dpflores/BLDC_Motor_Controller_SEM_2022/README.md

# BLDC_Motor_Controller_SEM_2022

Desarrollo del controlador de motor brushless DC utilizado por KON Team para la competencia Shell Eco-Marathon Brasil 2022. Este código se ha implementado en un microcontrolador STM32F103C8T6. 

Revisar la carpeta `documentation` para ver el desarrollo de hardware.

Saludos de parte del equipo de electrónica de KON Team.
