dpflores/BLDC_Motor_Controller_SEM_2022/documentation/1 cover.pdf

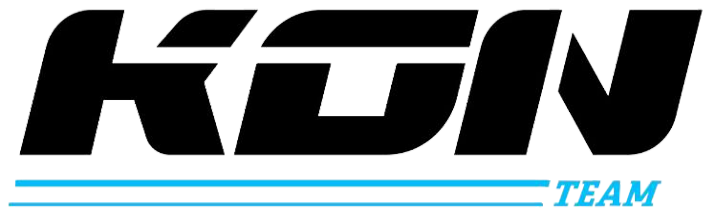
[picture p1: figure]

Motor Controller
Documentation

2021/2022

Team ID: PE0002001

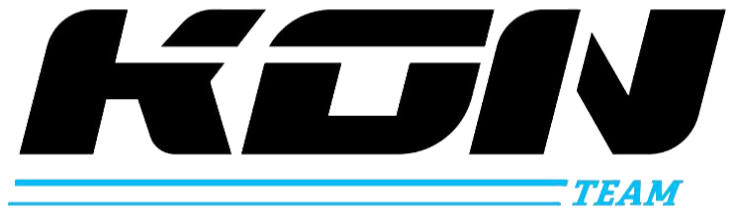
[picture p2: figure]

2
