dpflores/BLDC_Motor_Controller_SEM_2022/documentation/8 CAD model.pdf

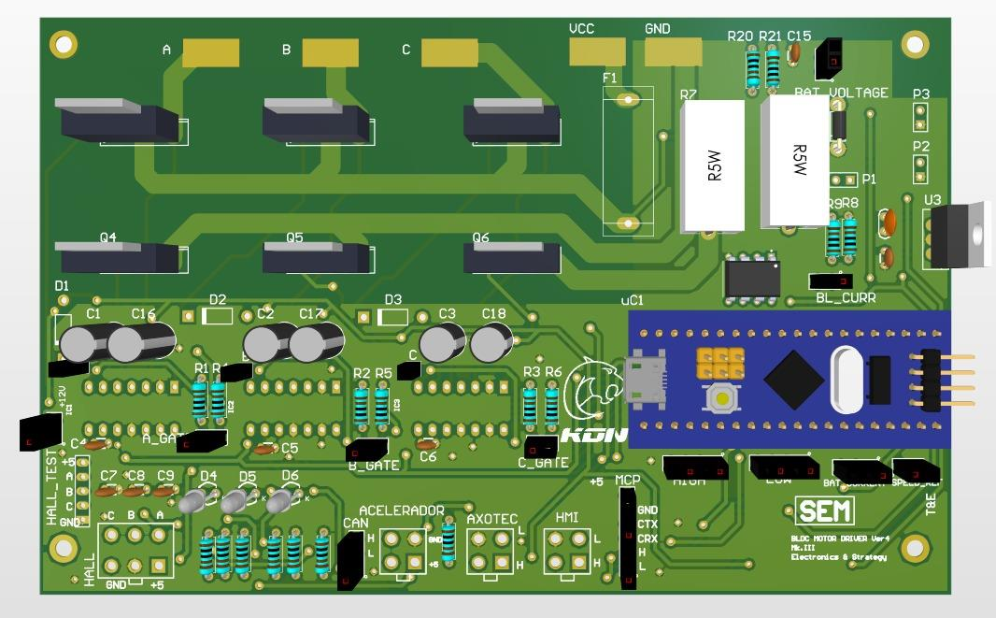
[picture p3: page 1]
