dpflores/BLDC_Motor_Controller_SEM_2022/documentation/4 PCBKon_Schematic.pdf

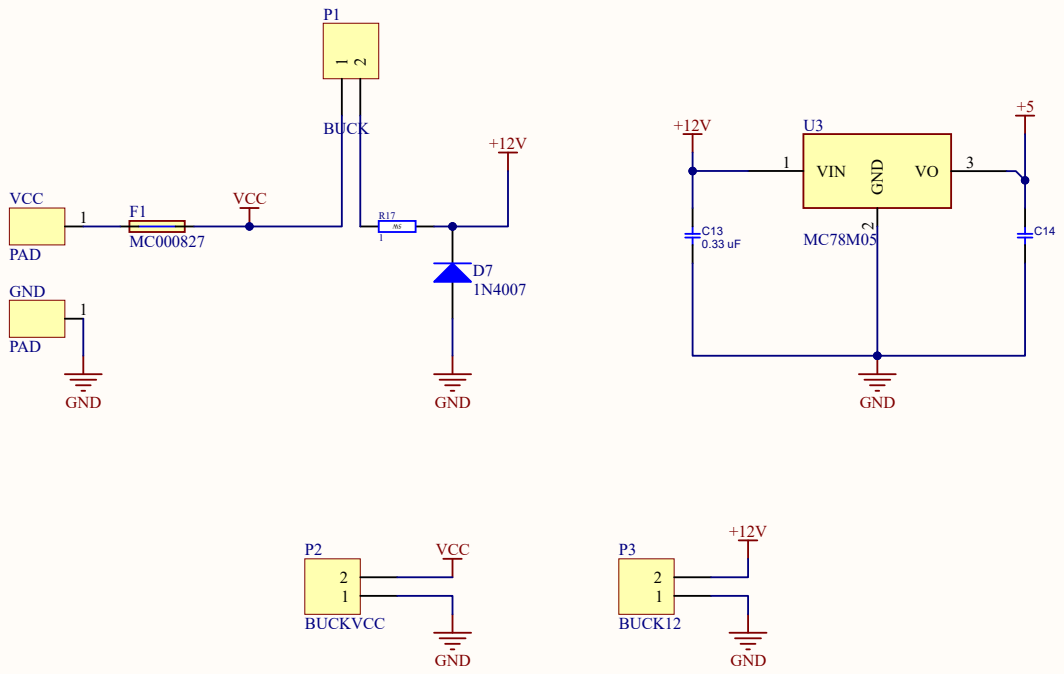
[picture p4: page 1]

Size A4 | Number | Revision

Date: 8/19/2022 | Sheet of
File: C:\Users\..\Buck.SchDoc | Drawn By:

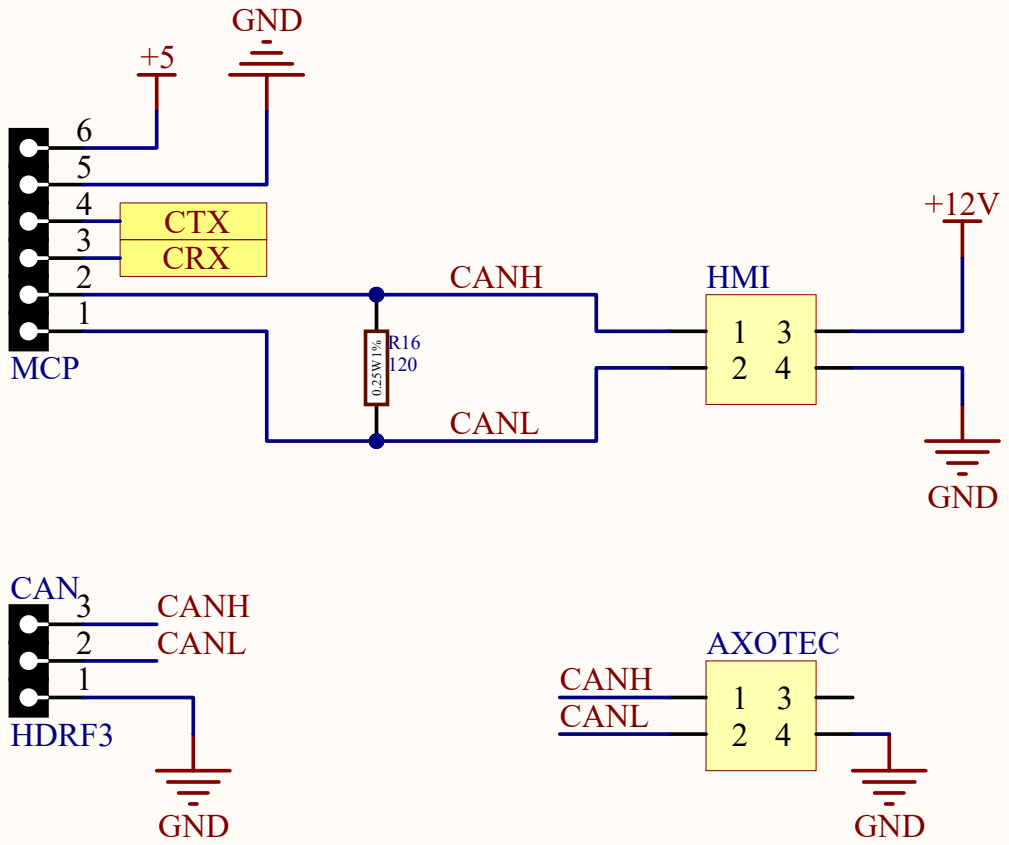
[picture p5: page 2]
Title; Size; Number; Revision; File:; C:\Users\..\CANBUS.SchDoc; Drawn By:; MCP; CTX CRX; GND; CANH; HMI; CANL; AXOTEC; 3 CAN; HDRF3; CANH CANL

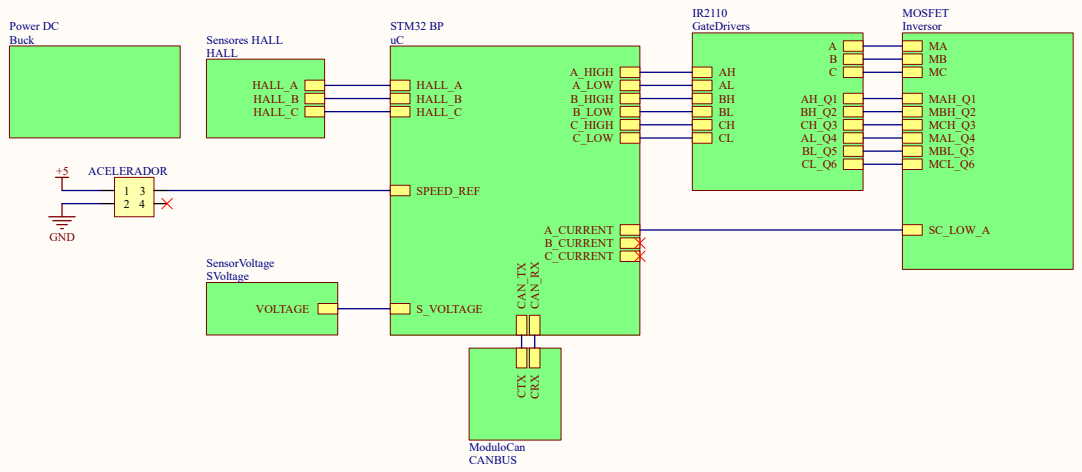
[picture p6: page 3]
Title; Size; Number; Revision; File:; C:\Users\..\Driverv4_1.SchDoc; Drawn By:; A_HIGH; HALL_A; CAN_TX; C_HIGH; B_HIGH; CAN_RX; HALL_B; C_LOW; A_LOW; SPEED_REF; HALL_C; B_LOW; A_CURRENT B_CURRENT C_CURRENT; S_VOLTAGE; STM32 BP; IR2110 GateDrivers; MAL_Q4; MAH_Q1; MCL_Q6; MBH_Q2 MCH_Q3; MBL_Q5; SC_LOW_A; MOSFET Inversor; CTX; CRX; ModuloCan CANBUS; HALL_A HALL_B HALL_C; Sensores HALL HALL; Power DC Buck; ACELERADOR; GND; VOLTAGE; SensorVoltage SVoltage

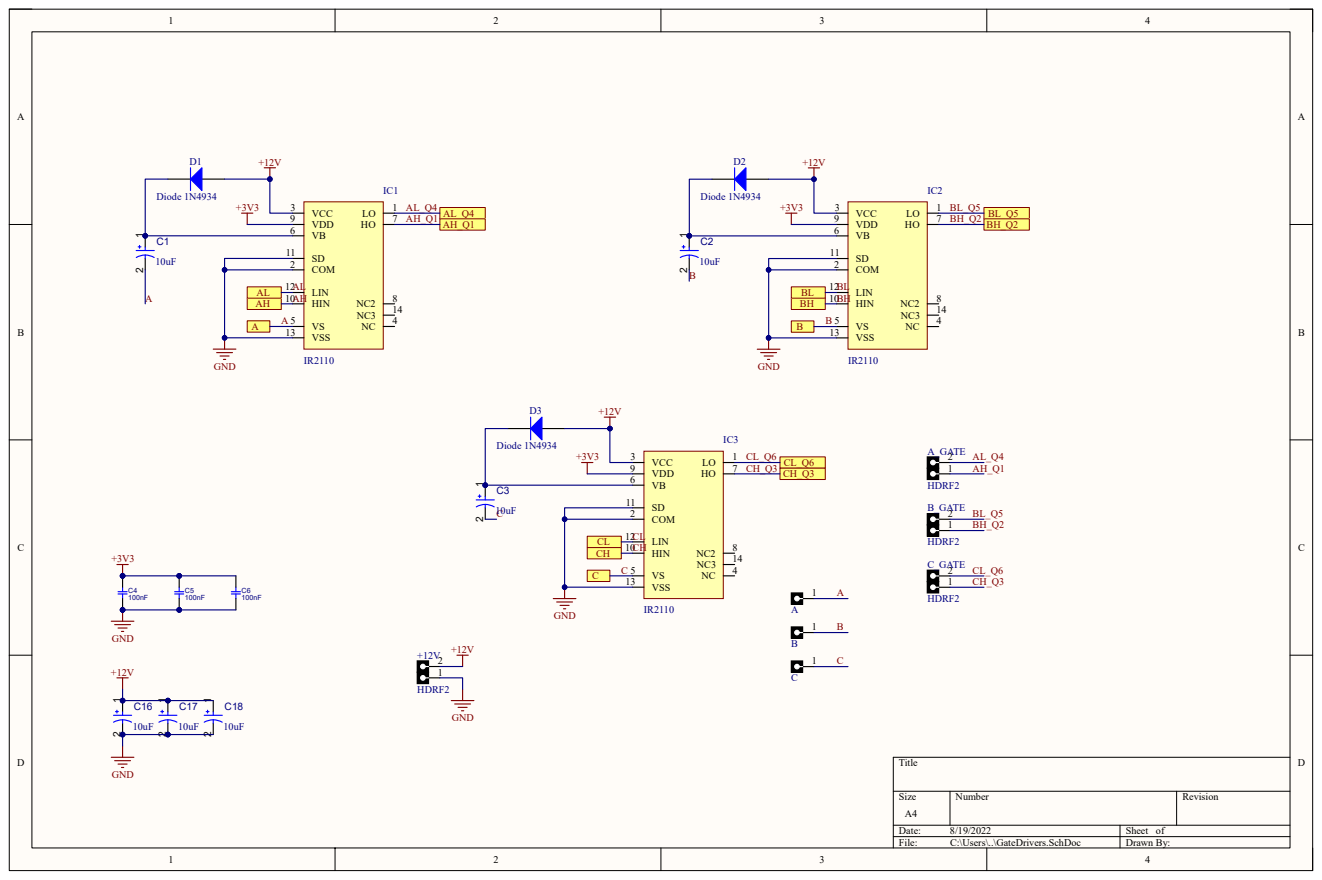
[picture p7: page 4]

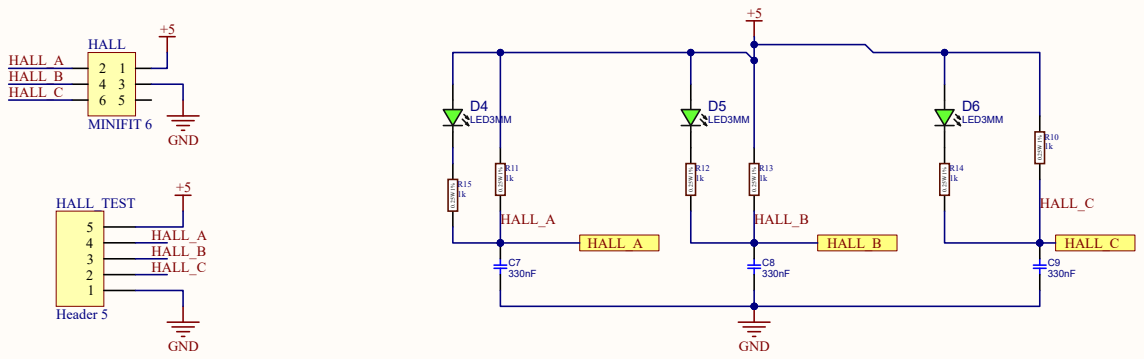
[picture p8: page 5]
Title; Size; Number; Revision; File:; C:\Users\..\HALL.SchDoc; Drawn By:; GND; HALL_A; HALL_B; HALL_C; HALL; MINIFIT 6; HALL_TEST; Header 5; HALL_A HALL_B HALL_C; LED3MM

# Ciruito Inversor de Potencia

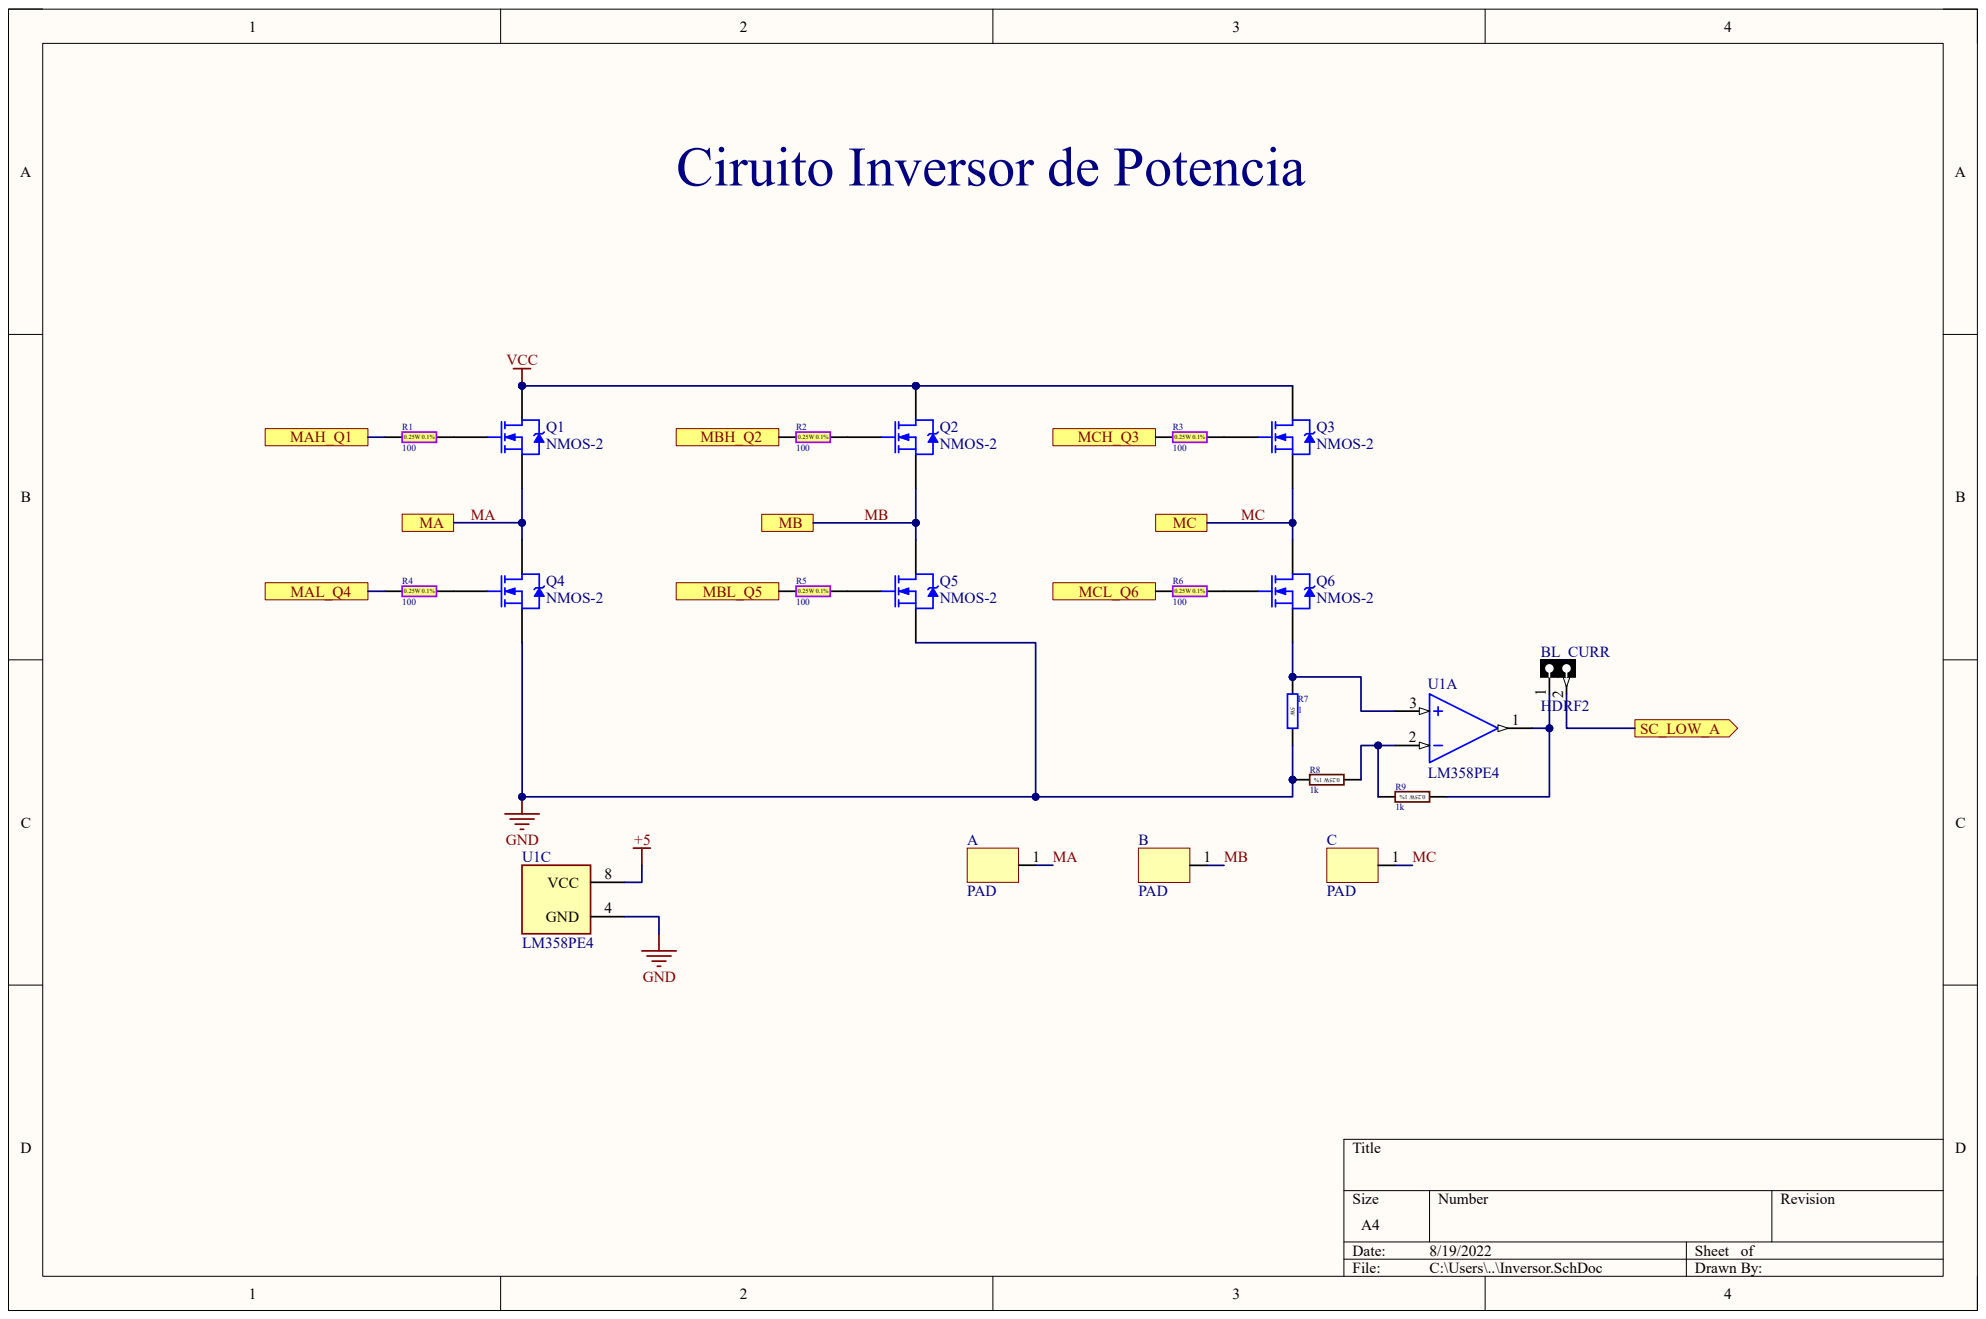
[picture p9: page 6]

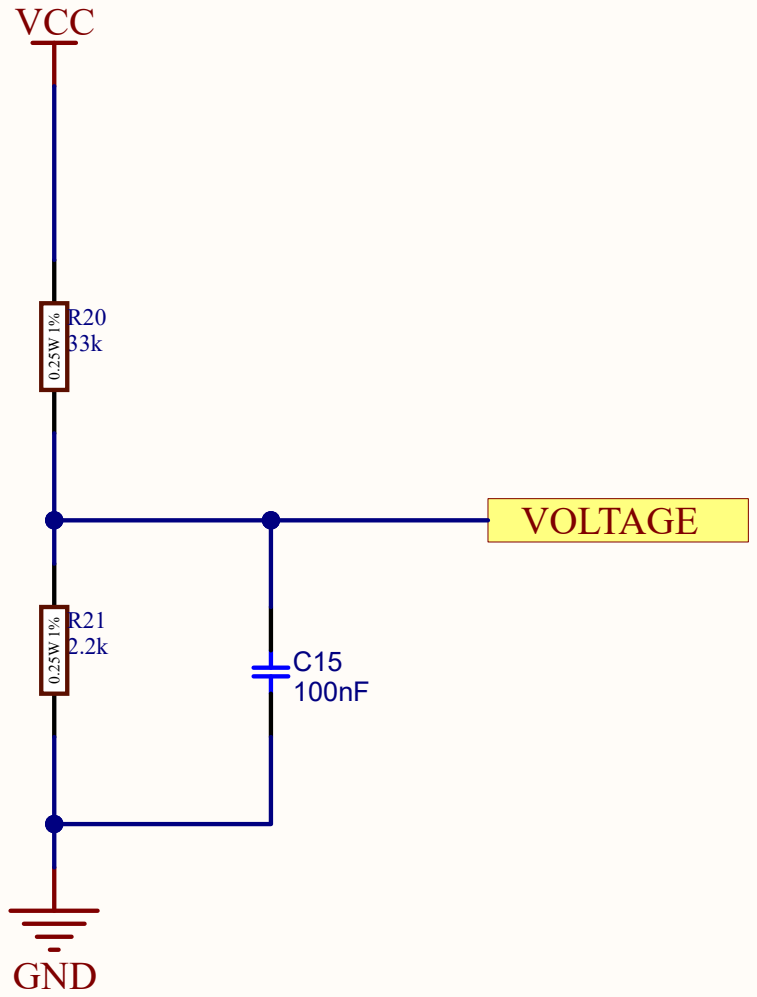
[picture p10: page 7]
Title; Size; Number; Revision; File:; C:\Users\..\SVoltage.SchDoc; Drawn By:; GND; VCC; VOLTAGE

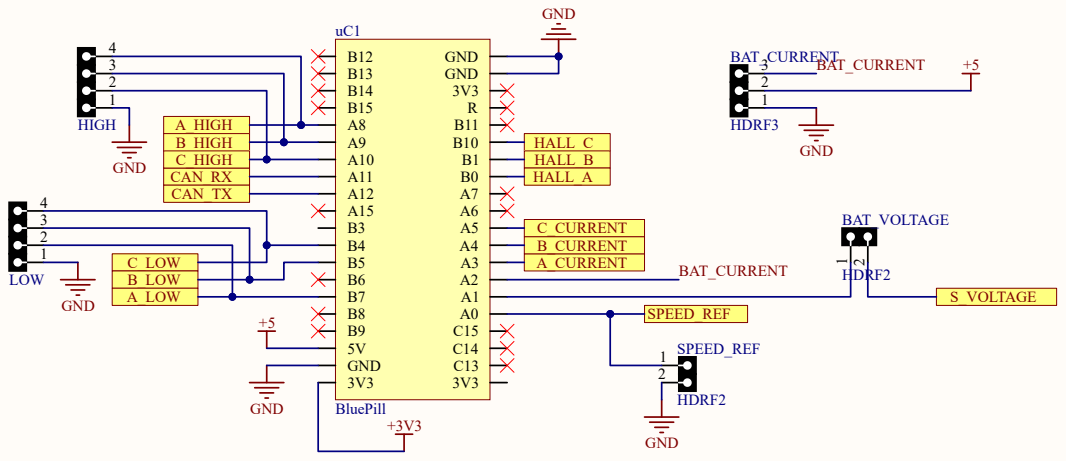
[picture p11: page 8]
Title; Size; Number; Revision; File:; C:\Users\..\uC.SchDoc; Drawn By:; GND; B13 B14 B15 A8 A9 A10 A11 A12 A15 B3 B4 B5 B6 B7 B8 B9 5V GND 3V3; BluePill; CAN_RX CAN_TX; A_HIGH B_HIGH C_HIGH; HALL_C HALL_B HALL_A; C_LOW B_LOW A_LOW; SPEED_REF; A_CURRENT; B_CURRENT; C_CURRENT; S_VOLTAGE; HIGH; LOW; BAT_VOLTAGE; HDRF2; BAT_CURRENT; 3 BAT_CURRENT; HDRF3
