dpflores/BLDC_Motor_Controller_SEM_2022/documentation/15 Energy Supply.pdf

## Energy Supply Block Diagram - KON Team Mk III

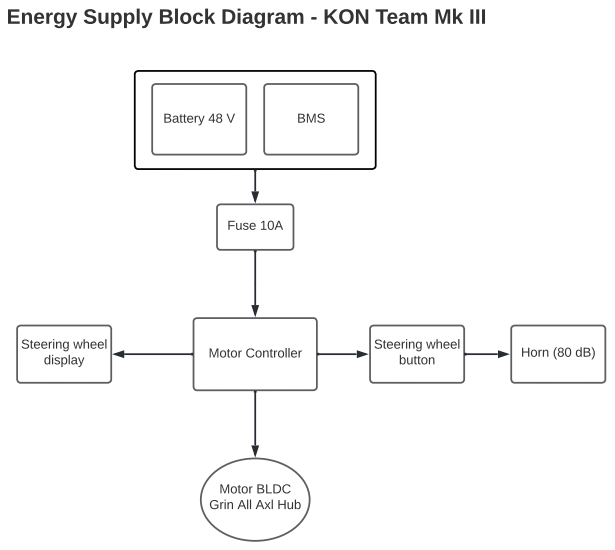
[picture p12: page 1]
Battery 48 V; BMS; Fuse 10A; Motor Controller; Steering wheel button

Horn (80 dB) Steering wheel
display

Motor BLDC
Grin All Axl Hub
