dpflores/BLDC_Motor_Controller_SEM_2022/documentation/16 Propulsion System.pdf

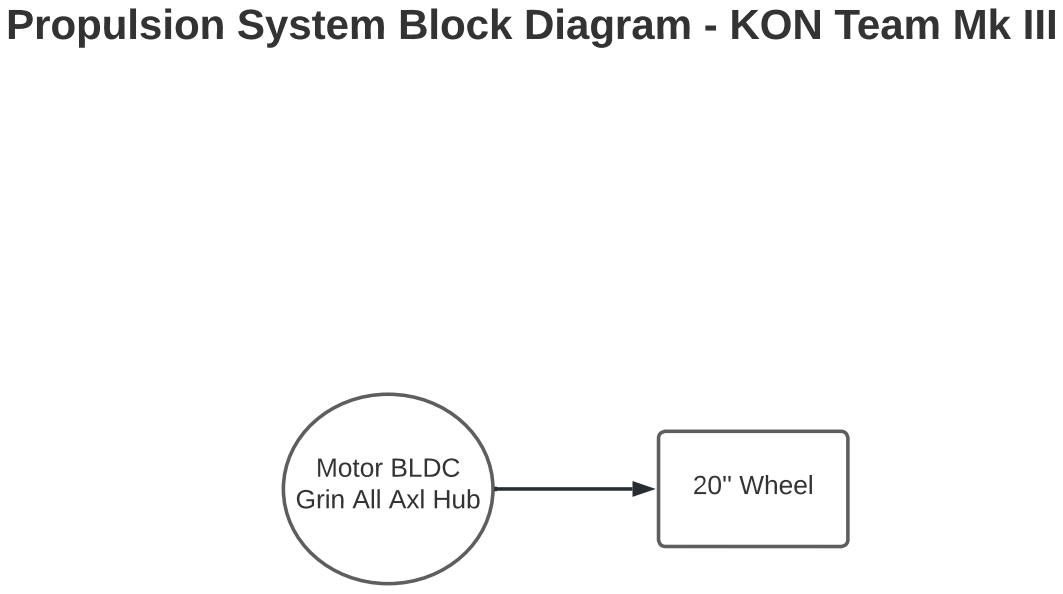
[picture p13: page 1]
20'' Wheel

Propulsion System Block Diagram - KON Team Mk III

Motor BLDC
Grin All Axl Hub
