dpflores/BLDC_Motor_Controller_SEM_2022/documentation/2 Block diagram.pdf

# Electronic Speed Controller (Hardware)

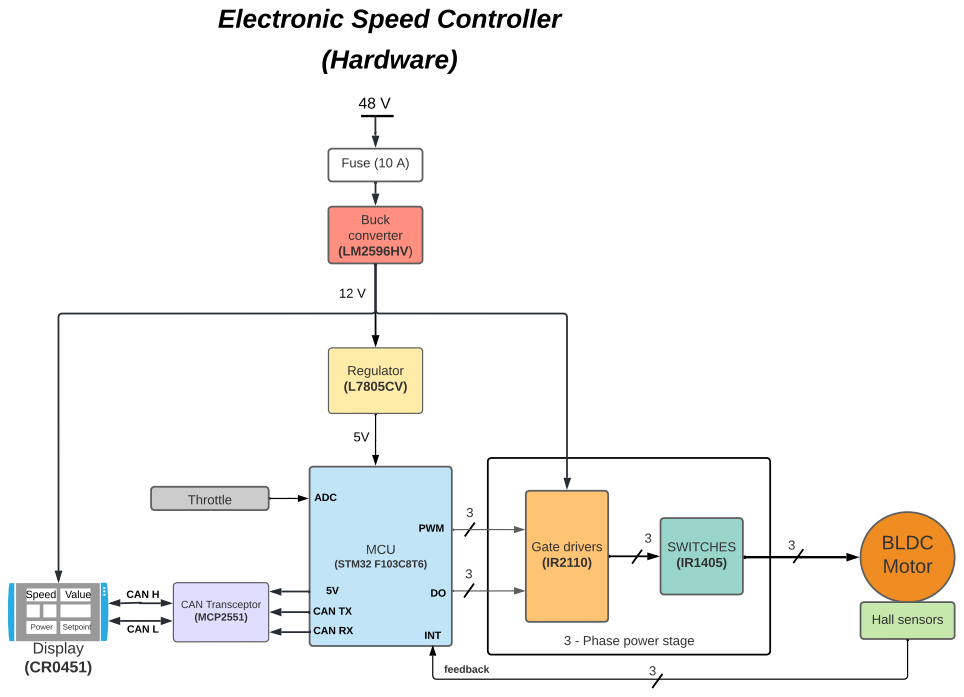
[picture p14: page 1]
Buck converter (LM2596HV); MCU (STM32 F103C8T6); BLDC Motor; Hall sensors; Gate drivers (IR2110); SWITCHES (IR1405); feedback; Throttle; Regulator (L7805CV); ADC; CAN TX; PWM; INT; Fuse (10 A); CAN RX; CAN Transceptor (MCP2551); CAN L; CAN H; Display (CR0451); Speed Value; Power Setpoint

3 - Phase power stage
