dpflores/BLDC_Motor_Controller_SEM_2022/documentation/3 Flowcharts.pdf

### MAIN PROGRAM

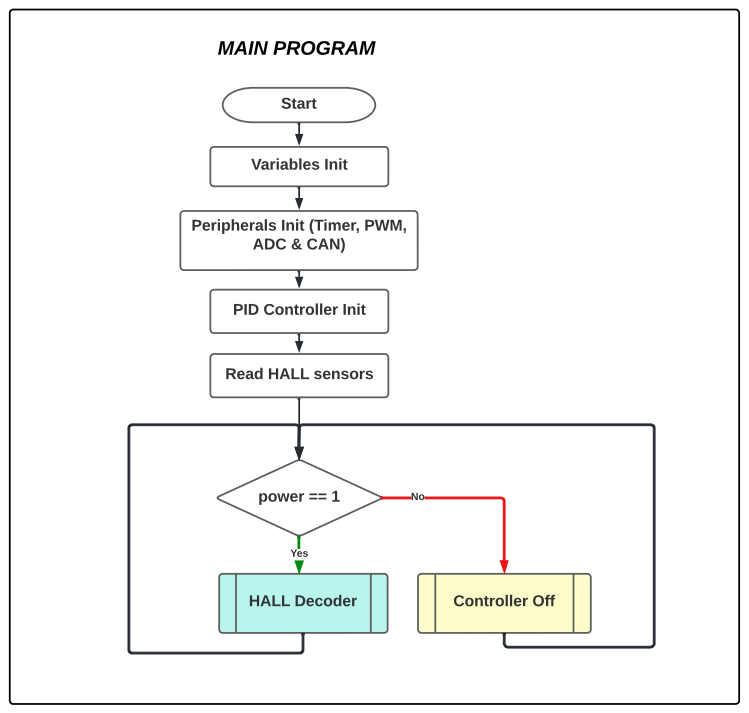
[picture p15: page 1]
Start; Variables Init; power == 1; HALL Decoder; Yes; Controller Off; ADC & CAN)

Peripherals Init (Timer, PWM,

PID Controller Init

Read HALL sensors

### HALL Decoder Subroutine

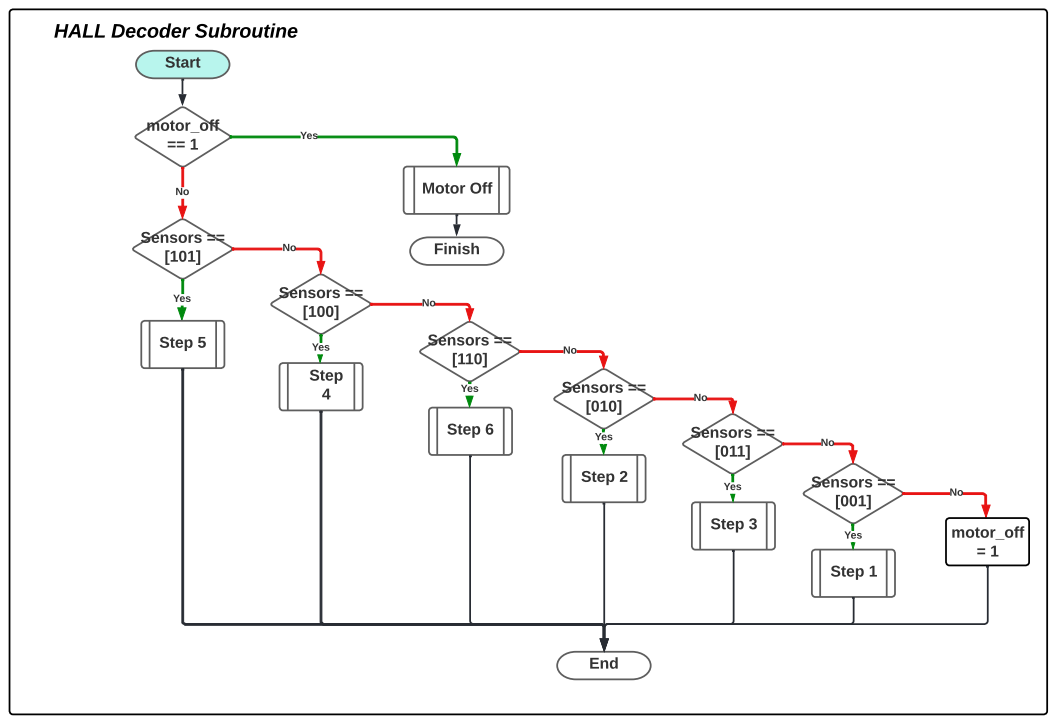
[picture p16: page 2]
Sensors == [101]; Yes; Step 5; Sensors == [100]; Step 4; Sensors ==; Step 6; Sensors == [010]; Step 2; Sensors == [011]; Step 3; Sensors == [001]; Step 1; Start; End; motor_off == 1; Motor Off; Finish; motor_off = 1

### Interrupt routines

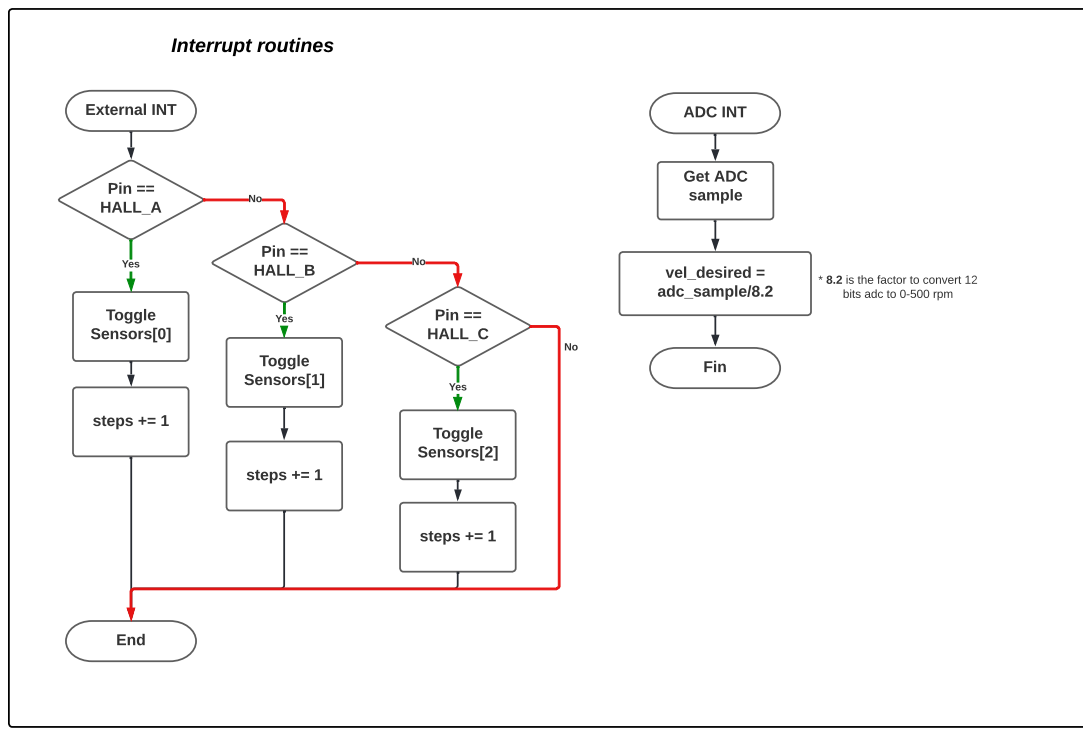
[picture p17: page 3]
External INT; Pin == HALL_A; Toggle Sensors[0]; Yes; steps += 1; End; Pin == HALL_B; Toggle Sensors[1]; Pin == HALL_C; Toggle Sensors[2]; ADC INT; Get ADC sample; vel_desired = adc_sample/8.2; Fin

* 8.2 is the factor to convert 12
bits adc to 0-500 rpm

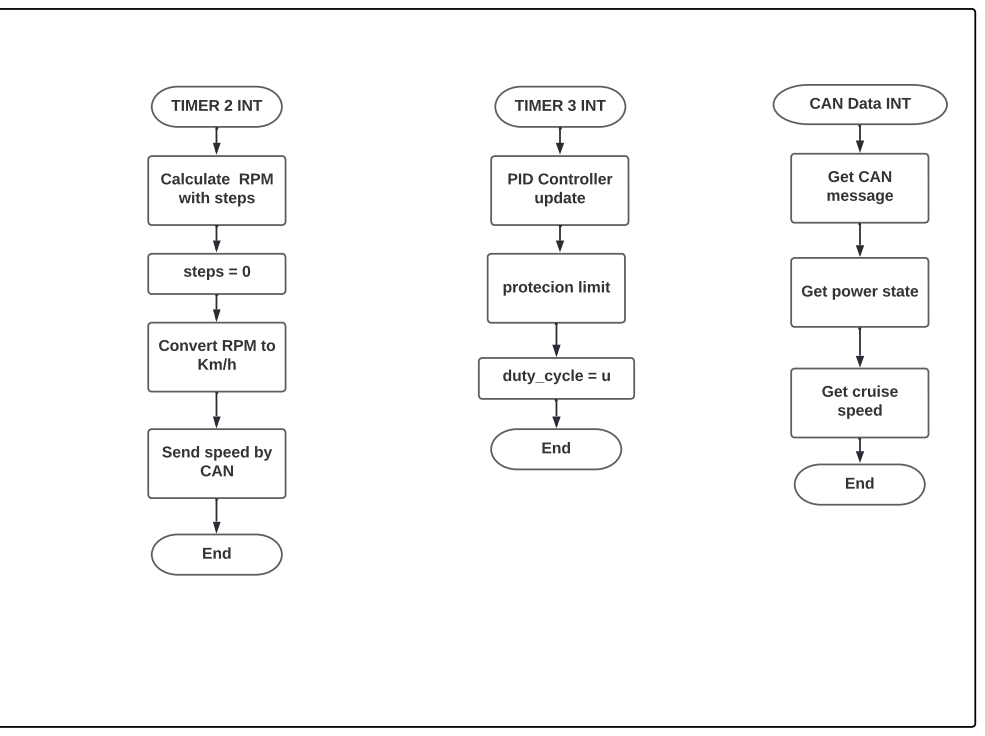
[picture p18: page 4]
TIMER 2 INT; Calculate RPM with steps; steps = 0; End; TIMER 3 INT; PID Controller update; protecion limit; duty_cycle = u; Get CAN message; Get cruise speed

CAN Data INT

Get power state

Convert RPM to

Send speed by
CAN
