dpflores/BLDC_Motor_Controller_SEM_2022/documentation/Final document.pdf

# Motor Controller Documentation

2021/2022

# Team ID: PE0002001

48 V

# Electronic Speed Controller

Buck converter (LM2596HV); MCU (STM32 F103C8T6); BLDC Motor; Hall sensors; Gate drivers (IR2110); SWITCHES (IR1405); feedback; Throttle; Regulator (L7805CV); (Hardware); ADC; CAN TX; PWM; INT; Fuse (10 A); CAN RX; CAN Transceptor (MCP2551); CAN L; CAN H; Display (CR0451); Speed Value; Power Setpoint

3 - Phase power stage

# Start

# Variables Init

power == 1; HALL Decoder; Yes; Controller Off; ADC & CAN); MAIN PROGRAM

Peripherals Init (Timer, PWM,

PID Controller Init

Read HALL sensors

# Start

# motor_off

Sensors == [101]; Yes; Step 5; Sensors == [100]; Step 4; Sensors ==; Step 6; Sensors == [010]; Step 2; Sensors == [011]; Step 3; Sensors == [001]; Step 1; End; Motor Off; Finish; motor_off = 1

HALL Decoder Subroutine

# External INT

# Interrupt routines

Pin == HALL_A; Toggle Sensors[0]; Yes; steps += 1; End; Pin == HALL_B; Toggle Sensors[1]; Pin == HALL_C; Toggle Sensors[2]; ADC INT; Get ADC sample; vel_desired = adc_sample/8.2; Fin

* 8.2 is the factor to convert 12
bits adc to 0-500 rpm

# TIMER 2 INT

# TIMER 3 INT

Calculate RPM with steps; steps = 0; End; PID Controller update; protecion limit; duty_cycle = u; Get CAN message; Get cruise speed

CAN Data INT

Get power state

Convert RPM to

Send speed by
CAN


Size A4 | Number | Revision

Date: 8/19/2022 | Sheet of
File: C:\Users\..\Buck.SchDoc | Drawn By:

Title; MCP; CTX CRX; GND; CANH; HMI; CANL; AXOTEC; 3 CAN; HDRF3; CANH CANL

Size A4 | Number | Revision

Date: 8/19/2022 | Sheet of
File: C:\Users\..\CANBUS.SchDoc | Drawn By:

Title; A_HIGH; HALL_A; CAN_TX; C_HIGH; B_HIGH; CAN_RX; HALL_B; C_LOW; A_LOW; SPEED_REF; HALL_C; B_LOW; A_CURRENT B_CURRENT C_CURRENT; S_VOLTAGE; STM32 BP; IR2110 GateDrivers; MAL_Q4; MAH_Q1; MCL_Q6; MBH_Q2 MCH_Q3; MBL_Q5; SC_LOW_A; MOSFET Inversor; CTX; CRX; ModuloCan CANBUS; HALL_A HALL_B HALL_C; Sensores HALL HALL; Power DC Buck; ACELERADOR; GND; VOLTAGE; SensorVoltage SVoltage

Size A4 | Number | Revision

Date: 8/19/2022 | Sheet of
File: C:\Users\..\Driverv4_1.SchDoc | Drawn By:


Size A4 | Number | Revision

Date: 8/19/2022 | Sheet of
File: C:\Users\..\GateDrivers.SchDoc | Drawn By:

Title; GND; HALL_A; HALL_B; HALL_C; HALL; MINIFIT 6; HALL_TEST; Header 5; HALL_A HALL_B HALL_C; LED3MM

Size A4 | Number | Revision

Date: 8/19/2022 | Sheet of
File: C:\Users\..\HALL.SchDoc | Drawn By:

# Ciruito Inversor de Potencia


Size A4 | Number | Revision

Date: 8/19/2022 | Sheet of
File: C:\Users\..\Inversor.SchDoc | Drawn By:

Title; GND; VCC; VOLTAGE

Size A4 | Number | Revision

Date: 8/19/2022 | Sheet of
File: C:\Users\..\SVoltage.SchDoc | Drawn By:

Title; GND; B13 B14 B15 A8 A9 A10 A11 A12 A15 B3 B4 B5 B6 B7 B8 B9 5V GND 3V3; BluePill; CAN_RX CAN_TX; A_HIGH B_HIGH C_HIGH; HALL_C HALL_B HALL_A; C_LOW B_LOW A_LOW; SPEED_REF; A_CURRENT; B_CURRENT; C_CURRENT; S_VOLTAGE; HIGH; LOW; BAT_VOLTAGE; HDRF2; BAT_CURRENT; 3 BAT_CURRENT; HDRF3

Size A4 | Number | Revision

Date: 8/19/2022 | Sheet of
File: C:\Users\..\uC.SchDoc | Drawn By:

10uF | C1, C2, C3, C16, C17, C18 | 6
100uF 100V | C10 | 1

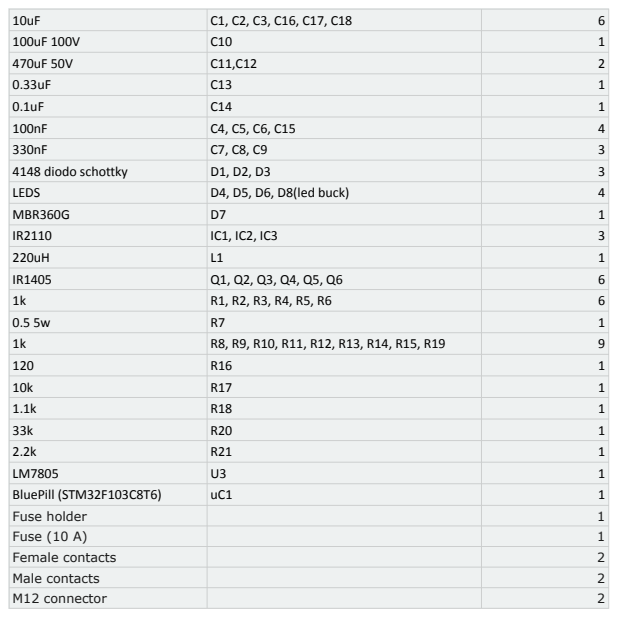
[picture p19: page 15]

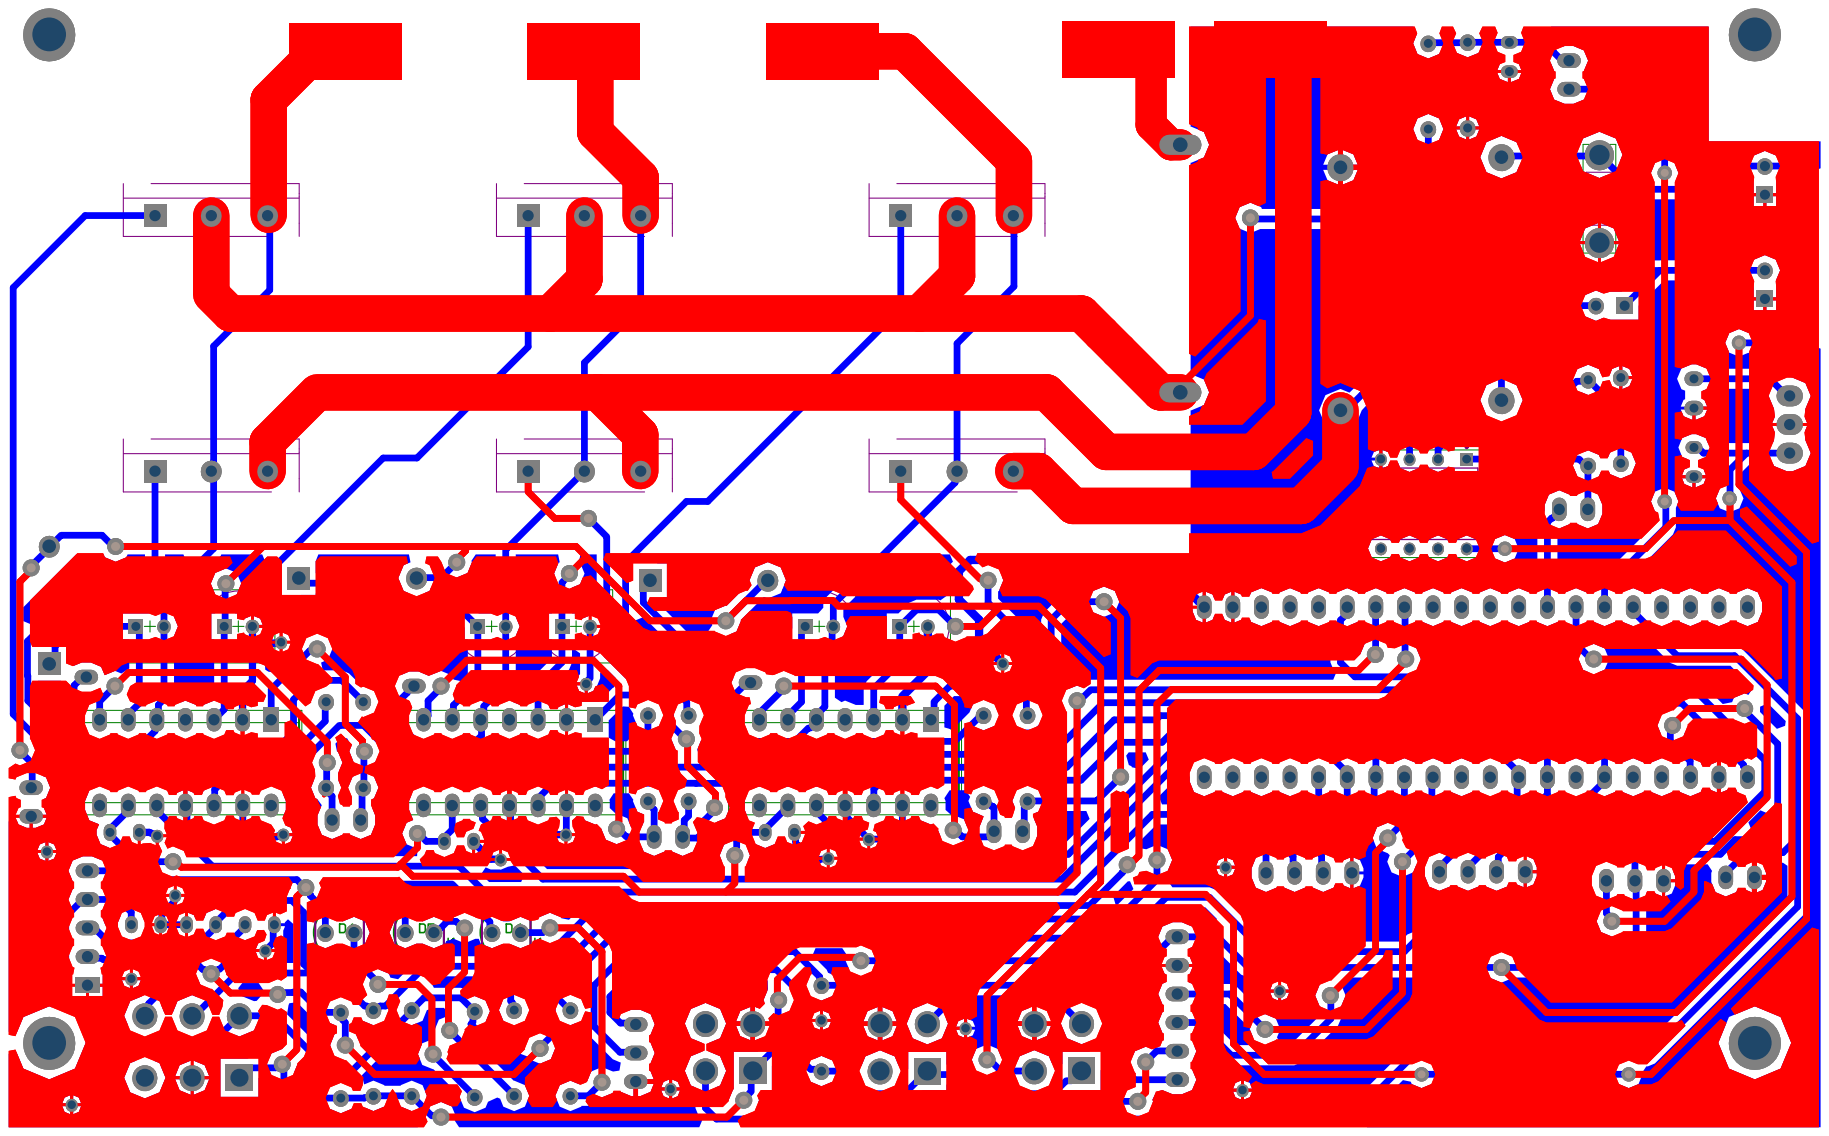
[picture p20: page 16]

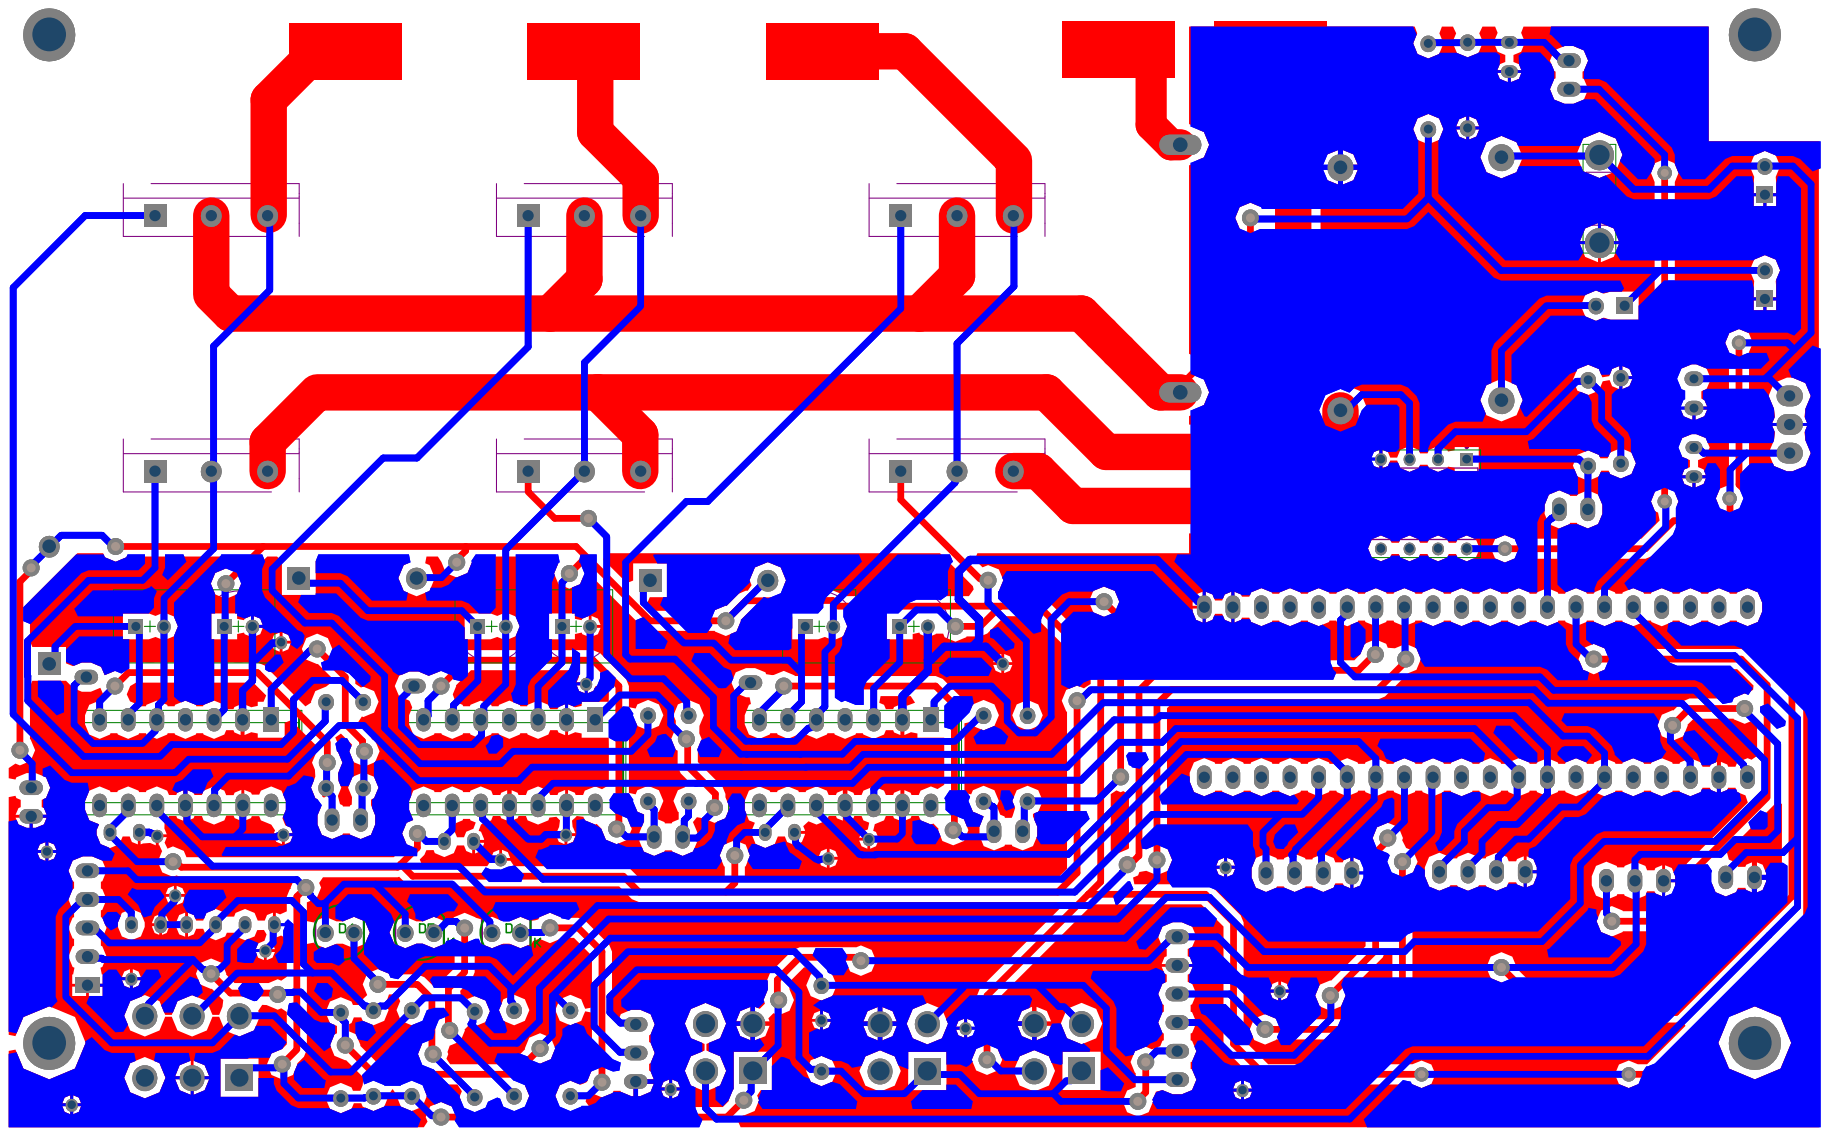
[picture p21: page 17]


| Parameter | Max. | Units
ID @ TC = 25°C | Continuous Drain Current, VGS @ 10V | 169
ID @ TC = 100°C | Continuous Drain Current, VGS @ 10V | 118 | A
IDM | Pulsed Drain Current | 680
PD @TC = 25°C | Power Dissipation | 330 | W
| Linear Derating Factor | 2.2 | W/°C
VGS | Gate-to-Source Voltage | ± 20 | V
EAS | Single Pulse Avalanche Energy | 560 | mJ
IAR | Avalanche Current | See Fig.12a, 12b, 15, 16 | A
EAR | Repetitive Avalanche Energy | | mJ
dv/dt | Peak Diode Recovery dv/dt | 5.0 | V/ns
TJ | Operating Junction and | -55 to + 175
TSTG | Storage Temperature Range
| Soldering Temperature, for 10 seconds | 300 (1.6mm from case ) | °C
| Mounting Torque, 6-32 or M3 screw | 10 lbf•in (1.1N•m)

# HEXFET® Power MOSFET

Specifically designed for Automotive applications, this Stripe Planar design of HEXFET® Power MOSFETs utilizes the lastest processing techniques to achieve extremely low on-resistance per silicon area. Additional features of this HEXFET power MOSFET are a 175°C junction operating temperature, fast switching speed and improved repetitive avalanche rating. These benefits combine to make this design an extremely efficient and reliable device for use in Automotive applications and a

wide variety of other applications.

S

D

G

# Absolute Maximum Ratings

# VDSS = 55V

# RDS(on) = 5.3mΩ

# ID = 169A

# Description

3/25/01

www.irf.com | 1

## - Advanced Process Technology - Ultra Low On-Resistance - Dynamic dv/dt Rating - 175°C Operating Temperature - Fast Switching - Repetitive Avalanche Allowed up to Tjmax

# Benefits

# AUTOMOTIVE MOSFET

# Thermal Resistance

| Parameter | Typ. | Max. | Units
RθJC | Junction-to-Case | ––– | 0.45 | °C/W
RθCS | Case-to-Sink, Flat, Greased Surface | 0.50 | –––
RθJA | Junction-to-Ambient | ––– | 62

## TO-220AB

## PD -93991A

# IRF1405

# Typical Applications

## - Electric Power Steering (EPS) - Anti-lock Braking System (ABS) - Wiper Control - Climate Control - Power Door

# Features

### - Floating channel designed for bootstrap operation

### Fully operational to +500V or +600V Tolerant to negative transient voltage dV/dt immune - Gate drive supply range from 10 to 20V - Undervoltage lockout for both channels - 3.3V logic compatible

### Separate logic supply range from 3.3V to 20V Logic and power ground ±5V offset - CMOS Schmitt-triggered inputs with pull-down - Cycle by cycle edge-triggered shutdown logic - Matched propagation delay for both channels - Outputs in phase with inputs

### Data Sheet No. PD60147 rev.V

# HIGH AND LOW SIDE DRIVER

# Product Summary

VOFFSET (IR2110) (https://www.infineon.com/cms/en/product/power/gate-driver-ics/ir2110s/) | 500V max.
(IR2113) (https://www.infineon.com/cms/en/product/power/gate-driver-ics/ir2113s/) | 600V max.
IO+/- | 2A / 2A
VOUT | 10 - 20V
ton/off (typ.) | 120 & 94 ns

Delay Matching (IR2110) 10 ns max. (IR2113) 20ns max.

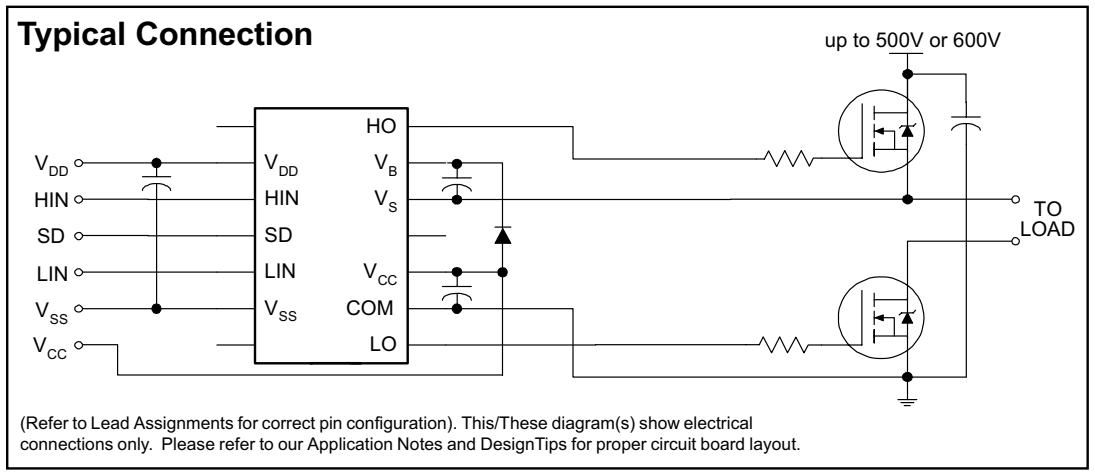
[picture p22: figure]
Typical Connection

www.infineon.com/gatedriver | 1

# Description

The IR2110/IR2113 are high voltage, high speed power MOSFET and IGBT drivers with independent high and low side referenced output channels. Proprietary HVIC and latch immune CMOS technologies enable ruggedized monolithic construction. Logic inputs are compatible with standard CMOS or LSTTL output, down to 3.3V logic. The output drivers feature a high pulse current buffer stage designed for minimum

driver cross-conduction. Propagation delays are matched to simplify use in high frequency applications. The floating channel can be used to drive an N-channel power MOSFET or IGBT in the high side configuration which operates up to 500 or 600 volts.

# IR2110(S)PbF/IR2113(S)PbF

(Refer to Lead Assignments for correct pin configuration). This/These diagram(s) show electrical connections only. Please refer to our Application Notes and DesignTips for proper circuit board layout.

# Packages

14-Lead PDIP IR2110/IR2113 | 16-Lead SOIC IR2110S/IR2113S

60V, 3A, 150kHz, Step-down Switching Regulator | LM2596HV
Feb. 2020 – R1.1 | - 1 - | HTC

# FEATURES

- 3.3V, 5V, 12V and Adjustable output versions - Adjustable version output voltage range, 1.23V to 57V - ±4% max over line and load condition - Available in TO-220, TO-263 and SOP-8PP - Guaranteed 3A output load current - Input voltage range up to 60V - Requires only 4 external components - Excellent line and load regulation specifications - 150kHz fixed frequency internal oscillator - Low power standby mode, ISTB typically 30uA - High efficiency - Thermal shutdown and current limit protection - Output short protection by reduction of frequency by 3 times

# APPLICATION

# - Simple high-efficiency step-down (buck) regulator - Efficient pre-regulator for linear regulators - On-card switching regulators

# DESCRIPTION

# SOP-8PP PKG

# TO-263 PKG

# TO-220 PKG

## ORDERING INFORMATION

Device | Package
LM2596HVGDP-ADJ | SOP-8PP LM2596HVGDP-X.X
LM2596HVGR-ADJ | TO-263 5L LM2596HVGR-X.X
LM2596HVGT-ADJ | TO-220 5L LM2596HVGT-X.X

## X.X = Output Voltage = 3.3, 5.0, 12

The LM2596HV series of regulators are monolithic integrated circuits that provide all the active functions for a step-down (buck) switching regulator, capable of driving a 3A load with excellent line and load regulation. These devices are available in fixed output voltages of 3.3V, 5V, 12V, and an adjustable output version.
Available in a standard 5-lead TO-220 package and a 5-lead TO-263 surface mount package.
External shutdown is included, featuring typically 30 μA standby current. The output switch includes cycle-by-cycle current limiting, as well as thermal shutdown, and protection from output short for full protection under fault conditions.

# Absolute Maximum Ratings ⁽Note 1)

CHARACTERISTIC | SYMBOL | MIN. | MAX. | UNIT
Supply Voltage | VIN | - | 63 | V
ON/OFF Pin Input Voltage | VON/OFF | -0.3 | 60 (or VIN) | V
FB pin voltage | VFB | -0.3 | 25 (or VIN) | V
Output voltage to GND | VOUT | -1 | | V
Storage Temperature Range | TSTG | -65 | 150 | ℃
Maximum Junction Temperature Range | TJ,MAX | - | 150 | ℃

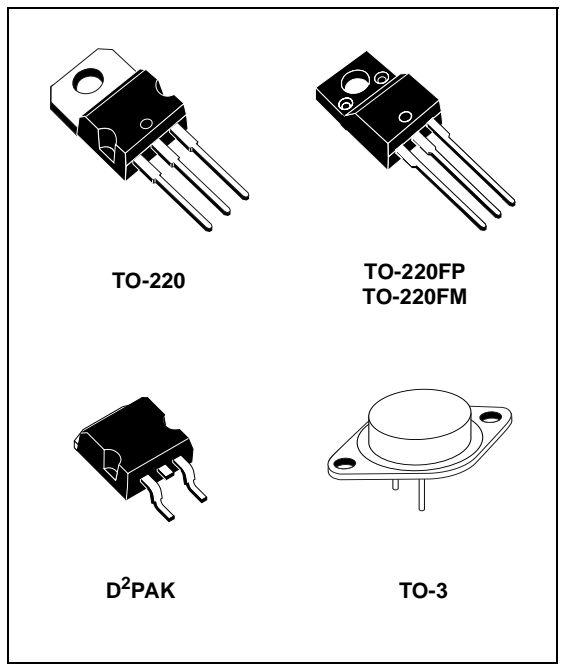
[picture p23: figure]
D²PAK
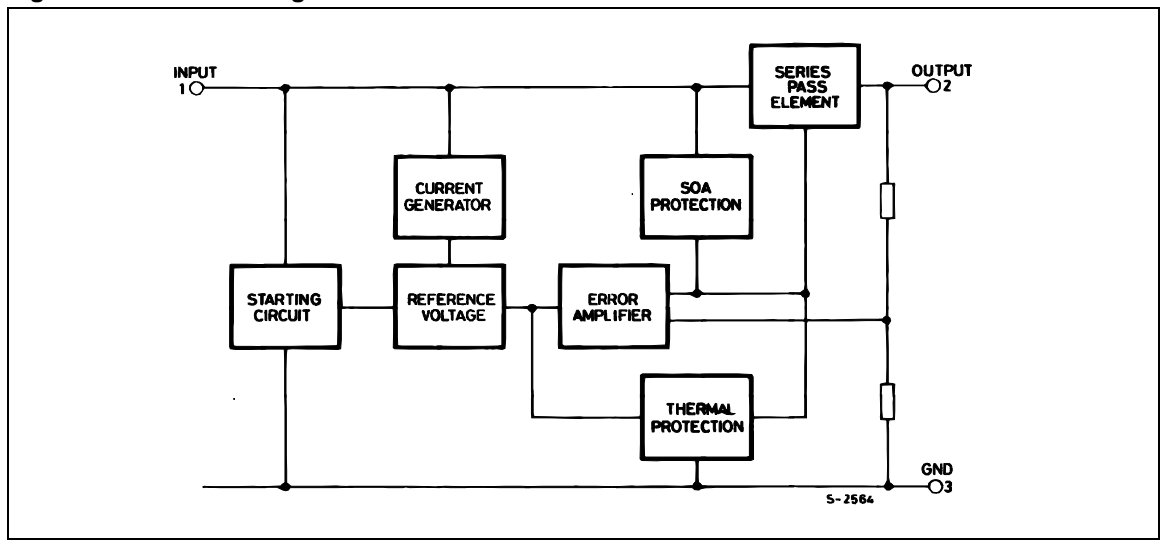
[picture p24: figure]

November 2004 | 1/34
■ | OUTPUT CURRENT TO 1.5A
■ | OUTPUT VOLTAGES OF 5; 5.2; 6; 8; 8.5; 9; 10; 12; 15; 18; 24V
■ | THERMAL OVERLOAD PROTECTION
■ | SHORT CIRCUIT PROTECTION
■ | OUTPUT TRANSITION SOA PROTECTION

## DESCRIPTION The L7800 series of three-terminal positive

regulators is available in TO-220, TO-220FP,

TO-220FM, TO-3 and D²PAK packages and several fixed output voltages, making it useful in a wide range of applications. These regulators can provide local on-card regulation, eliminating the distribution problems associated with single point regulation. Each type employs internal current limiting, thermal shut-down and safe area protection, making it essentially indestructible. If adequate heat sinking is provided, they can deliver over 1A output current. Although designed primarily as fixed voltage regulators, these devices can be used with external components to

obtain adjustable voltage and currents.

L7800

# SERIES

# POSITIVE VOLTAGE REGULATORS

## Figure 1: Schematic Diagram

## Rev. 12

# MCP2551

# Features

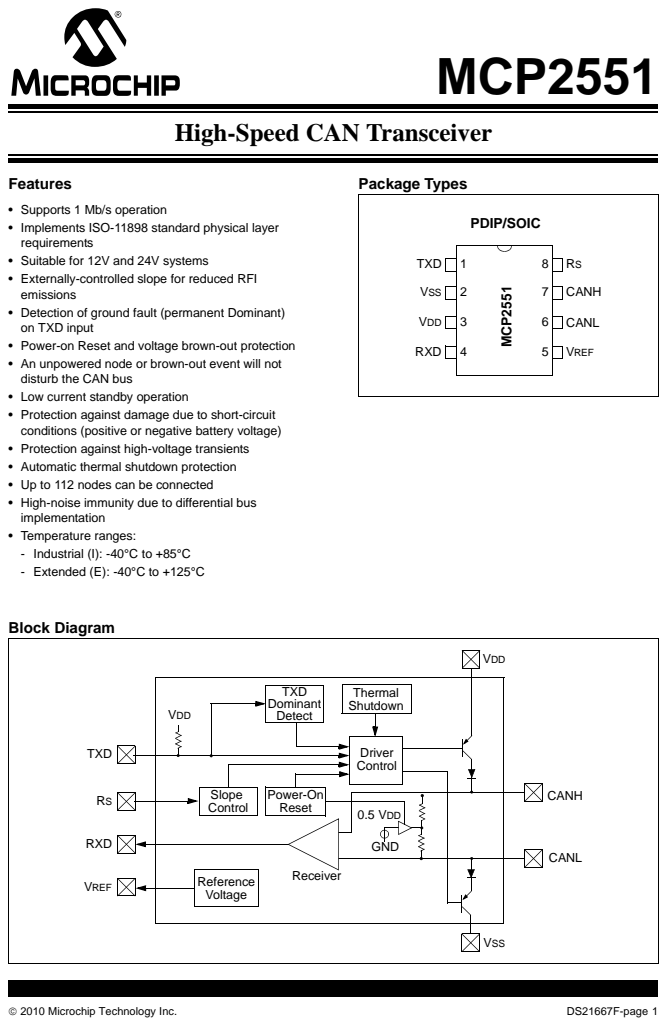
[picture p25: page 23]
© 2010 Microchip Technology Inc.; DS21667F-page 1; Package Types; Block Diagram; CANH; CANL; VREF; TXD; VSS; VDD; RXD; Thermal Shutdown; Slope Control; Power-On Reset; Reference Voltage; Receiver; GND; 0.5 VDD; TXD Dominant Detect; Driver Control

High-Speed CAN Transceiver

• Supports 1 Mb/s operation
• Implements ISO-11898 standard physical layer
requirements
• Suitable for 12V and 24V systems
• Externally-controlled slope for reduced RFI
emissions
• Detection of ground fault (permanent Dominant)
on TXD input
• Power-on Reset and voltage brown-out protection
• An unpowered node or brown-out event will not
disturb the CAN bus
• Low current standby operation
• Protection against damage due to short-circuit
conditions (positive or negative battery voltage)
• Protection against high-voltage transients
• Automatic thermal shutdown protection
• Up to 112 nodes can be connected
• High-noise immunity due to differential bus
implementation
• Temperature ranges:
- Industrial (I): -40°C to +85°C
- Extended (E): -40°C to +125°C

PDIP/SOIC MCP²⁵⁵¹

# 复位电路

BOOTx设置 | LED灯，D2可编程

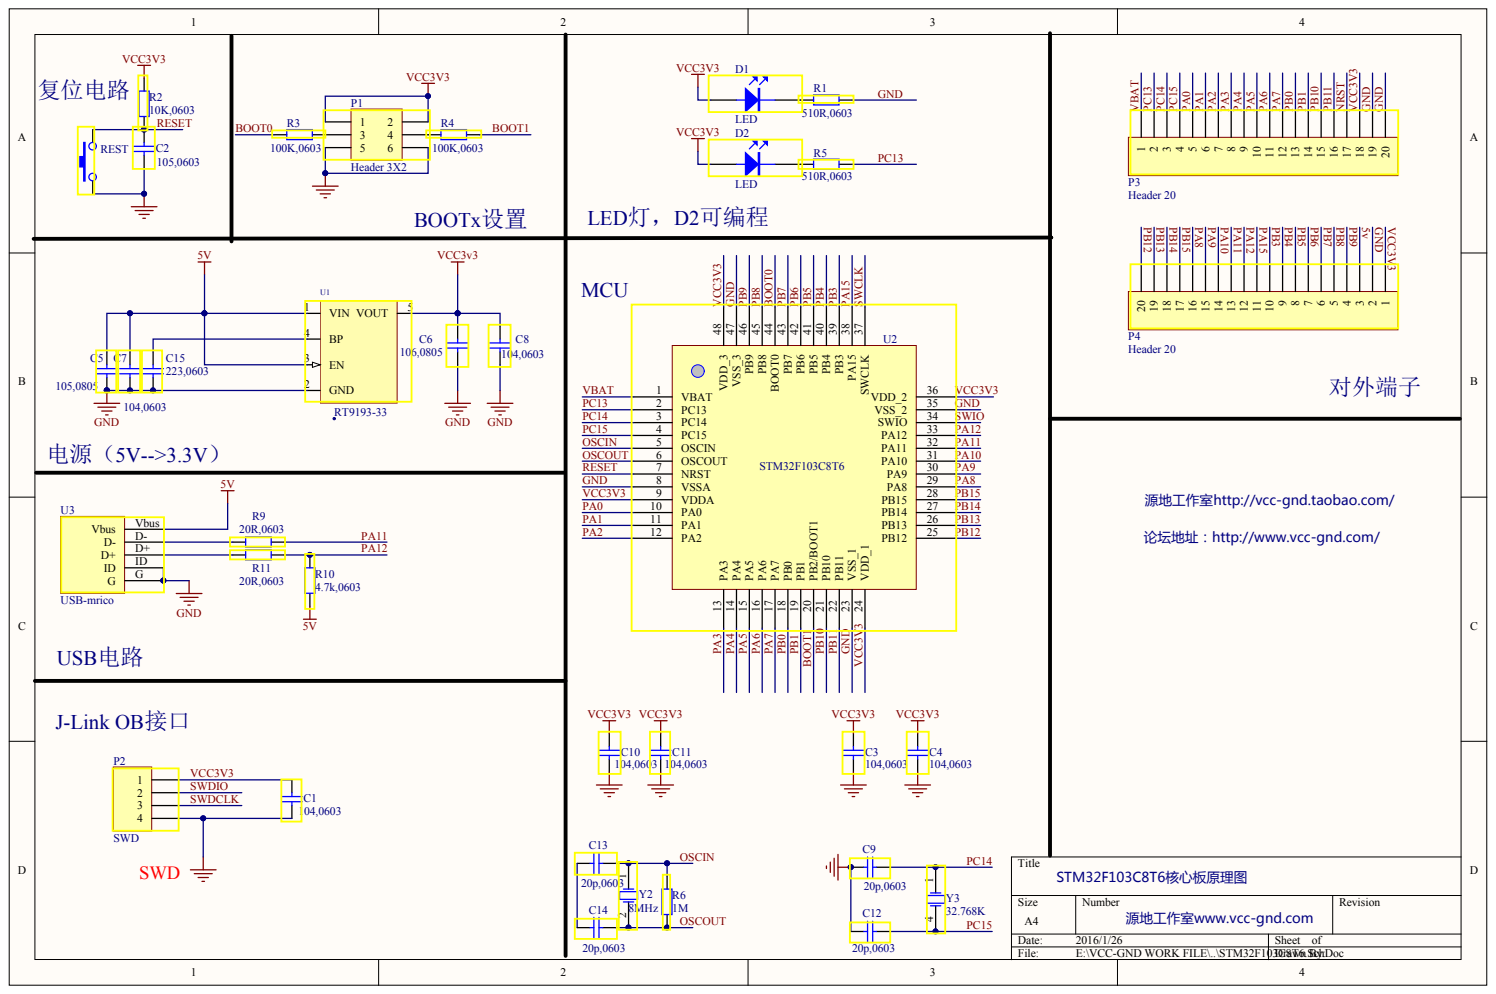
[picture p26: page 24]

36 WCLK ³⁷ PA¹⁵ ³⁸ PB³ ³⁹ PB⁴ ⁴⁰ PB⁵ ⁴¹ PB⁶ ⁴² PB⁷ ⁴³ BOOT⁰ ⁴⁴ PB⁸ ⁴⁵ PB⁹ ⁴⁶ VSS_3 47 VDD_3 48

源地工作室http://vcc-gnd.taobao.com/

论坛地址：http://www.vcc-gnd.com/

源地工作室www.vcc-gnd.com

Battery 48 V | BMS

# Energy Supply Block Diagram - KON Team Mk III

Fuse 10A; Motor Controller; Steering wheel button

Horn (80 dB) Steering wheel
display

Motor BLDC
Grin All Axl Hub

# Propulsion System Block Diagram - KON Team Mk III

20'' Wheel

Motor BLDC
Grin All Axl Hub
