dpflores/BLDC_Motor_Controller_SEM_2022/Core/Src/main.c

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
/* Includes ------------------------------------------------------------------*/
#include "main.h"

/* USER CODE BEGIN Includes */


#include "PID.h"

/* USER CODE END Includes */

/* USER CODE BEGIN PD */


/* Controller parameters */
#define PID_KP  0.04f
#define PID_KI  0.1f
#define PID_KD  0.0f

#define PID_TAU 0.02f

#define PID_LIM_MIN  0.0f
#define PID_LIM_MAX  255.0f

#define SAMPLE_TIME_S 0.01f


/* CAN data */

//Position of the respective data flags

#define GF 0u  	// General flag
#define PW 1u	// Power flag
#define EM 2u	// Emergency flag
#define SU 3u	// Speed unit
#define CS0 4u	// Cruice Speed 0
#define CS1 5u	// Cruice Speed 1




/* USER CODE END PD */

ADC_HandleTypeDef hadc1;

CAN_HandleTypeDef hcan;

TIM_HandleTypeDef htim1;
TIM_HandleTypeDef htim2;
TIM_HandleTypeDef htim3;

void SystemClock_Config(void);
static void MX_GPIO_Init(void);
static void MX_ADC1_Init(void);
static void MX_TIM1_Init(void);
static void MX_TIM2_Init(void);
static void MX_CAN_Init(void);
static void MX_TIM3_Init(void);
/* USER CODE BEGIN 0 */

//FUNCTIONS
void show_velocity(uint16_t vel); //Shows integer Velocity using three digits

void Hall_Decoder(void); // Makes the hall encoding for commutation



//VARIABLES

uint8_t power = 0; // Power state

int Sensors[3] = {0,0,0}; //Hall sensors (A, B, C)

float duty_cycle = 0; //Duty cycle para el PWM

uint16_t adc_sample = 0;

uint8_t counts = 0;

float adc_sum = 0;

uint16_t adc_av = 0; // adc_average

float vel_d = 0; //desired velocity


float cruise_factor1 = 7.29; // factor to obtain the first cruise speed (35 km/h)

float cruise_factor2 = 8.5; // factor to obtain the second cruise speed (30 km/h)

float cruise_factor3 = 10.2; // factor to obtain the second cruise speed (25 km/h)

float cruise_factor = 7.29; // General cruise factor, initial value with 1

uint16_t steps = 0; // Number of steps by the motor

float vel_rpm = 0; // Number of steps by the motor

float velocity = 0; // Any of the other velocities

float rpm2kmh = 10.44; // rpm speed to km/h factor (se divide los rpm por esto para obtener en km/h)

//CONTROL VALUES


float error = 0; //difference between desired and measured speed

float cumError = 0; //error*elapsedTime


float proportional = 0; // Proportional part

float integral = 0; //Integral part

float u = 0; //control law

//CAN VARIABLES

uint8_t CAN_FLAG_REG;	// Register of flags for can


CAN_TxHeaderTypeDef TxHeader;
CAN_RxHeaderTypeDef RxHeader;

uint32_t TxMailbox;
uint32_t FreeMailbox; // Check the amount of mailboxes free


uint8_t TxData[8];
uint8_t RxData[8];


//PID
PIDController pid = { PID_KP, PID_KI, PID_KD, PID_TAU,
						PID_LIM_MIN, PID_LIM_MAX, SAMPLE_TIME_S };

// Motor variables

uint8_t motor_off = 0;

void HAL_CAN_RxFifo0MsgPendingCallback(CAN_HandleTypeDef *hcan)
{
	HAL_CAN_GetRxMessage(hcan, CAN_RX_FIFO0, &RxHeader, RxData);

	if (RxData[0] == 96 && RxData[1] == 234){ // HMI Page 60000

		if (RxData[4] == 1){ //HMI button 1
			power = 1;
		}
		if (RxData[4] == 2){ //HMI button 2
			power = 0;
		}


		if (RxData[5] == 16){ //HMI down button
			//TxData[4] = 0;		//Change button color
			CAN_FLAG_REG &= ~(1 << CS1);
			CAN_FLAG_REG &= ~(1 << CS0); //Cruise speed 0

		}
		if (RxData[5] == 8){ //HMI left button
			//TxData[4] = 1; 		//Change button color
			CAN_FLAG_REG &= ~(1 << CS1);
			CAN_FLAG_REG |=  (1 << CS0); //Cruise speed 1

		}
		if (RxData[5] == 32){ //HMI right button
			//TxData[4] = 2;		//Change button color
			CAN_FLAG_REG |=  (1 << CS1);
			CAN_FLAG_REG &= ~(1 << CS0); //Cruise speed 2

		}
		if (RxData[5] == 2){ //HMI up button
			//TxData[4] = 3;		//Change button color
			CAN_FLAG_REG |=  (1 << CS1);
			CAN_FLAG_REG |=  (1 << CS0); //Cruise speed 3

		}

	}
}


/* USER CODE END 0 */

/**
  * @brief  The application entry point.
  * @retval int
  */
int main(void)
{
  /* MCU Configuration--------------------------------------------------------*/

  /* Reset of all peripherals, Initializes the Flash interface and the Systick. */
  HAL_Init();

  /* Configure the system clock */
  SystemClock_Config();

  /* Initialize all configured peripherals */
  MX_GPIO_Init();
  MX_ADC1_Init();
  MX_TIM1_Init();
  MX_TIM2_Init();
  MX_CAN_Init();
  MX_TIM3_Init();
  /* USER CODE BEGIN 2 */

  //Starting timer2 (0.5 seconds) to show speed
  HAL_TIM_Base_Start_IT(&htim2);

  //Starting timer3 (0.01 seconds) for speed control
  HAL_TIM_Base_Start_IT(&htim3);

  //CAN
  HAL_CAN_Start(&hcan);

  //CAN FIFO activation
  HAL_CAN_ActivateNotification(&hcan, CAN_IT_RX_FIFO0_MSG_PENDING);

  //Configurando la transmision

  TxHeader.DLC = 8;  // Son 8 bytes de data
  TxHeader.ExtId = 0;
  TxHeader.IDE = CAN_ID_STD; //Identificador del mensaje
  TxHeader.RTR = CAN_RTR_DATA;
  TxHeader.StdId = 0x103;  // Este es el ID que mandaremos al periferico
  TxHeader.TransmitGlobalTime = DISABLE;

  // CAN_FLAG_REG Initialization
  CAN_FLAG_REG |=  (1<<GF);	// General Flag 1 (necessary)
  //CAN_FLAG_REG &= ~(1<<SU); // Speed RPM
  CAN_FLAG_REG |=  (1<<SU); // Speed km/h
  CAN_FLAG_REG &= ~(1<<EM); // No Emergency
  CAN_FLAG_REG &= ~(1<<PW); // Initial OFF
  CAN_FLAG_REG &= ~(1<<CS0); //
  CAN_FLAG_REG &= ~(1<<CS1); // Cruise speed0


  TxData[0] = 0; 	//Speed component
  TxData[1] = 0;	//Speed component
  TxData[2] = 0;
  TxData[3] = 0;
  TxData[4] = 0;
  TxData[5] = 0;
  TxData[6] = 0;
  TxData[7] = CAN_FLAG_REG;	//Flags byte  [0 0 0 0 0 0 0 1] [x x cs cs su em pw gf]


  // x: not defined
  // cs: cruice speed (0 to 3)
  // su: speed units (0 for RPM, 1 for km/h)
  // em: emergency ( 1 for alert)
  // pw: Power flag (0 off, 1 on)
  // gf: general flag (1 always)


  /* USER CODE END 2 */

  /* Infinite loop */
  /* USER CODE BEGIN WHILE */


  /* Initialize PID controller */


  PIDController_Init(&pid);

  HAL_ADC_Start_IT(&hadc1);

  __HAL_TIM_SET_COMPARE(&htim1, TIM_CHANNEL_1, duty_cycle);
  __HAL_TIM_SET_COMPARE(&htim1, TIM_CHANNEL_2, duty_cycle);
  __HAL_TIM_SET_COMPARE(&htim1, TIM_CHANNEL_3, duty_cycle);

  //INITIAL POSITION

	//HALL A
	if (HAL_GPIO_ReadPin(HALL_A_GPIO_Port,HALL_A_Pin)) Sensors[0] = 1;
	else Sensors[0] = 0;
	//HALL B
	if (HAL_GPIO_ReadPin(HALL_B_GPIO_Port,HALL_B_Pin)) Sensors[1] = 1;
	else Sensors[1] = 0;
	//HALL C
	if (HAL_GPIO_ReadPin(HALL_C_GPIO_Port,HALL_C_Pin)) Sensors[2] = 1;
	else Sensors[2] = 0;



  while (1)
  {


	  if (power == 1){

		  HAL_ADC_Start_IT(&hadc1);

		  //HALL DECODER

		  Hall_Decoder(); //Makes the hall encoding


	  }

	  //Poner modo sleep

	  else{

		  //TURN OFF PID

		  PIDController_Reset(&pid);

		  integral = pid.integrator;

		  u = pid.out;

		  duty_cycle = u;


		  //Turn off the high gates
		  __HAL_TIM_SET_COMPARE(&htim1, TIM_CHANNEL_1, u);
		  __HAL_TIM_SET_COMPARE(&htim1, TIM_CHANNEL_2, u);
		  __HAL_TIM_SET_COMPARE(&htim1, TIM_CHANNEL_3, u);

		  //Turn off the low gates
		  HAL_GPIO_WritePin(C_LOW_GPIO_Port , C_LOW_Pin,  GPIO_PIN_RESET);
		  HAL_GPIO_WritePin(B_LOW_GPIO_Port , B_LOW_Pin,  GPIO_PIN_RESET);
		  HAL_GPIO_WritePin(A_LOW_GPIO_Port , A_LOW_Pin,  GPIO_PIN_RESET);

	  }

    /* USER CODE END WHILE */

    /* USER CODE BEGIN 3 */
  }
  /* USER CODE END 3 */
}

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
/* USER CODE BEGIN 4 */

//FUNCIONES



void Hall_Decoder(void){
	if (motor_off == 1){
		HAL_TIM_PWM_Stop(&htim1, TIM_CHANNEL_1);
		HAL_TIM_PWM_Stop(&htim1, TIM_CHANNEL_2);
		HAL_TIM_PWM_Stop(&htim1, TIM_CHANNEL_3);

		HAL_GPIO_WritePin(A_LOW_GPIO_Port , A_LOW_Pin,  GPIO_PIN_RESET);
		HAL_GPIO_WritePin(B_LOW_GPIO_Port , B_LOW_Pin,  GPIO_PIN_RESET);
		HAL_GPIO_WritePin(C_LOW_GPIO_Port , C_LOW_Pin,  GPIO_PIN_RESET);

	}
	else{
	if (Sensors[2] == 1 && Sensors[1] == 0 && Sensors[0] == 1) {
		HAL_TIM_PWM_Stop(&htim1, TIM_CHANNEL_2);
		HAL_TIM_PWM_Stop(&htim1, TIM_CHANNEL_3);


		HAL_GPIO_WritePin(C_LOW_GPIO_Port , C_LOW_Pin,  GPIO_PIN_RESET);
		HAL_GPIO_WritePin(A_LOW_GPIO_Port , A_LOW_Pin,  GPIO_PIN_RESET);


		//delay
		HAL_Delay(0.001);

		HAL_TIM_PWM_Start(&htim1, TIM_CHANNEL_1);
		HAL_GPIO_WritePin(B_LOW_GPIO_Port , B_LOW_Pin,  GPIO_PIN_SET);



	}
	else if(Sensors[2] == 1 && Sensors[1] == 0 && Sensors[0] == 0) {

		HAL_TIM_PWM_Stop(&htim1, TIM_CHANNEL_1);
		HAL_TIM_PWM_Stop(&htim1, TIM_CHANNEL_2);

		HAL_GPIO_WritePin(C_LOW_GPIO_Port , C_LOW_Pin,  GPIO_PIN_RESET);
		HAL_GPIO_WritePin(A_LOW_GPIO_Port , A_LOW_Pin,  GPIO_PIN_RESET);


		//delay
		HAL_Delay(0.001);

		HAL_TIM_PWM_Start(&htim1, TIM_CHANNEL_3);
		HAL_GPIO_WritePin(B_LOW_GPIO_Port , B_LOW_Pin,  GPIO_PIN_SET);

	}

	else if(Sensors[2] == 1 && Sensors[1] == 1 && Sensors[0] == 0) {

		HAL_TIM_PWM_Stop(&htim1, TIM_CHANNEL_1);
		HAL_TIM_PWM_Stop(&htim1, TIM_CHANNEL_2);

		HAL_GPIO_WritePin(C_LOW_GPIO_Port , C_LOW_Pin,   GPIO_PIN_RESET);
		HAL_GPIO_WritePin(B_LOW_GPIO_Port , B_LOW_Pin,  GPIO_PIN_RESET);


		//delay
		HAL_Delay(0.001);

		HAL_TIM_PWM_Start(&htim1, TIM_CHANNEL_3);
		HAL_GPIO_WritePin(A_LOW_GPIO_Port , A_LOW_Pin,  GPIO_PIN_SET);

	}

	else if(Sensors[2] == 0 && Sensors[1] == 1 && Sensors[0] == 0) {

		HAL_TIM_PWM_Stop(&htim1, TIM_CHANNEL_1);
		HAL_TIM_PWM_Stop(&htim1, TIM_CHANNEL_3);

		HAL_GPIO_WritePin(C_LOW_GPIO_Port , C_LOW_Pin,  GPIO_PIN_RESET);
		HAL_GPIO_WritePin(B_LOW_GPIO_Port , B_LOW_Pin,  GPIO_PIN_RESET);


		//delay
		HAL_Delay(0.001);

		HAL_TIM_PWM_Start(&htim1, TIM_CHANNEL_2);
		HAL_GPIO_WritePin(A_LOW_GPIO_Port , A_LOW_Pin,  GPIO_PIN_SET);

	}

	else if(Sensors[2] == 0 && Sensors[1] == 1 && Sensors[0] == 1) {

		HAL_TIM_PWM_Stop(&htim1, TIM_CHANNEL_1);
		HAL_TIM_PWM_Stop(&htim1, TIM_CHANNEL_3);

		HAL_GPIO_WritePin(B_LOW_GPIO_Port , B_LOW_Pin,  GPIO_PIN_RESET);
		HAL_GPIO_WritePin(A_LOW_GPIO_Port , A_LOW_Pin,  GPIO_PIN_RESET);


		//delay
		HAL_Delay(0.001);

		HAL_TIM_PWM_Start(&htim1, TIM_CHANNEL_2);
		HAL_GPIO_WritePin(C_LOW_GPIO_Port , C_LOW_Pin,  GPIO_PIN_SET);

	}

	else if(Sensors[2] == 0 && Sensors[1] == 0 && Sensors[0] == 1) {

		HAL_TIM_PWM_Stop(&htim1, TIM_CHANNEL_2);
		HAL_TIM_PWM_Stop(&htim1, TIM_CHANNEL_3);

		HAL_GPIO_WritePin(B_LOW_GPIO_Port , B_LOW_Pin,  GPIO_PIN_RESET);
		HAL_GPIO_WritePin(A_LOW_GPIO_Port , A_LOW_Pin,  GPIO_PIN_RESET);


		//delay
		HAL_Delay(0.001);

		HAL_TIM_PWM_Start(&htim1, TIM_CHANNEL_1);
		HAL_GPIO_WritePin(C_LOW_GPIO_Port , C_LOW_Pin,  GPIO_PIN_SET);

	}
	}
}

//INTERRUPCIONES

//ADC INTERRUPT
void HAL_ADC_ConvCpltCallback(ADC_HandleTypeDef* hadc){

	adc_sample = HAL_ADC_GetValue(&hadc1);

	/*
	adc_sum+= adc_sample/16.06;  // 16.06 para convertir de 12 bits a 8 bits
	counts += 1;

	if (counts == 150){
	  adc_av = adc_sum/counts;
	  adc_sum = 0;
	  counts = 0;

	}

	vel_d = adc_av/cruise_factor;
	duty_cycle = adc_av;
	*/

	//PI control (reference)
	adc_sum+= adc_sample/8.192;  // 13.65 para convertir de 12 bits a un intervalo de (0-500 rpm)
	counts += 1;

	if (counts == 1){
	  adc_av = adc_sum/counts;
	  adc_sum = 0;
	  counts = 0;

	}

	vel_d = adc_av;

}

//HALL INTERRUPTIONS
void HAL_GPIO_EXTI_Callback(uint16_t GPIO_Pin){


	//HALL A
	if (GPIO_Pin == GPIO_PIN_0) {

	if (HAL_GPIO_ReadPin(GPIOB,GPIO_PIN_0)) Sensors[0] = 1;
	else Sensors[0] = 0;

	steps+=1;
	}

	//HALL B
	else if (GPIO_Pin == GPIO_PIN_1) {

	if (HAL_GPIO_ReadPin(GPIOB,GPIO_PIN_1)) Sensors[1] = 1;
	else Sensors[1] = 0;

	steps+=1;
	}

	//HALL C
	else if (GPIO_Pin == GPIO_PIN_10) {

	if (HAL_GPIO_ReadPin(GPIOB,GPIO_PIN_10)) Sensors[2] = 1;
	else Sensors[2] = 0;

	steps+=1;
	}
}


void HAL_TIM_PeriodElapsedCallback(TIM_HandleTypeDef *htim){

	//INTERRUPTION TIMER 2 (0.5 s)
	if (htim->Instance == TIM2){

		//SPEED MEASUREMENT
		//Formula para el motor de prueba
//		vel_rpm = 2*60*steps/90;  //cada 0.5 SEGUNDOS se mide la cantidad de revoluciones por minuto
//		steps = 0;

		//Formula para el motor de MK III
		vel_rpm = 2*60*steps/138;
		steps = 0;

		//Enviamos el valor de la velocidad en RPM

		if (vel_rpm > 255){
			TxData[0] = 255;
			TxData[1] = vel_rpm - 255;
		}
		else{
			TxData[0] = vel_rpm;
			TxData[1] = 0;
		}

		// SI PUSIMOS A KM POR HORA (Quitar si se pone RPM)
		TxData[0] = vel_rpm/rpm2kmh;
		TxData[1] = 0;


		//Enviamos el estado ON OFF del sistema

		//CAN_FLAG_REG ^= (power ^ CAN_FLAG_REG) & (1 << PW);
		CAN_FLAG_REG = (CAN_FLAG_REG & (~(1 << PW))) | (power << PW); // Sending the ON (1) or OFF (0)
		//FreeMailbox = HAL_CAN_GetTxMailboxesFreeLevel(&hcan);
		//Send by CAN

		TxData[7] = CAN_FLAG_REG;
		HAL_CAN_AddTxMessage(&hcan, &TxHeader, TxData, &TxMailbox);


	}

	//INTERRUPTION TIMER 3 (0.01 s)
	if (htim->Instance == TIM3){



		//CONTROL

		PIDController_Update(&pid, vel_d, vel_rpm);

		// Protection
		if (vel_d<=10){
			PIDController_Reset(&pid);
			motor_off = 1;
		}
		else{
			motor_off = 0;
		}



		integral = pid.integrator;

		u = pid.out;

		duty_cycle = u;

		// Lazo abierto  (borrar despues para probar el lazo cerrado)

		duty_cycle = vel_d/2;

		if (duty_cycle<=15){
			duty_cycle = 0;
		}

		__HAL_TIM_SET_COMPARE(&htim1, TIM_CHANNEL_1, duty_cycle);
		__HAL_TIM_SET_COMPARE(&htim1, TIM_CHANNEL_2, duty_cycle);
		__HAL_TIM_SET_COMPARE(&htim1, TIM_CHANNEL_3, duty_cycle);

	}

}



/* USER CODE END 4 */
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
