dpflores/BLDC_Motor_Controller_SEM_2022/Core/Inc/main.h

#define SPEED_REF_Pin GPIO_PIN_0
#define SPEED_REF_GPIO_Port GPIOA
#define Test_out_Pin GPIO_PIN_4
#define Test_out_GPIO_Port GPIOA
#define HALL_A_Pin GPIO_PIN_0
#define HALL_A_GPIO_Port GPIOB
#define HALL_A_EXTI_IRQn EXTI0_IRQn
#define HALL_B_Pin GPIO_PIN_1
#define HALL_B_GPIO_Port GPIOB
#define HALL_B_EXTI_IRQn EXTI1_IRQn
#define HALL_C_Pin GPIO_PIN_10
#define HALL_C_GPIO_Port GPIOB
#define HALL_C_EXTI_IRQn EXTI15_10_IRQn
#define A_HIGH_Pin GPIO_PIN_8
#define A_HIGH_GPIO_Port GPIOA
#define B_HIGH_Pin GPIO_PIN_9
#define B_HIGH_GPIO_Port GPIOA
#define C_HIGH_Pin GPIO_PIN_10
#define C_HIGH_GPIO_Port GPIOA
#define C_LOW_Pin GPIO_PIN_4
#define C_LOW_GPIO_Port GPIOB
#define B_LOW_Pin GPIO_PIN_5
#define B_LOW_GPIO_Port GPIOB
#define A_LOW_Pin GPIO_PIN_7
#define A_LOW_GPIO_Port GPIOB
