dpflores/BLDC_Motor_Controller_SEM_2022/Core/Src/PID.c

/*
 * PID.c
 *
 *  Created on: Nov 21, 2021
 *      Author: del
 */

#include "PID.h"

void PIDController_Init(PIDController *pid) {

	/* Clear controller variables */
	pid->integrator = 0.0f;
	pid->prevError  = 0.0f;

	pid->differentiator  = 0.0f;
	pid->prevMeasurement = 0.0f;

	pid->out = 0.0f;

}

float PIDController_Update(PIDController *pid, float setpoint, float measurement) {

	/*
	* Error signal
	*/
    float error = setpoint - measurement;


	/*
	* Proportional
	*/
    float proportional = pid->Kp * error;


	/*
	* Integral
	*/
    pid->integrator = pid->integrator + 0.5f * pid->Ki * pid->T * (error + pid->prevError);

	/* Anti-wind-up via integrator clamping */
    if (pid->integrator > pid->limMax) {

        pid->integrator = pid->limMax;

    } else if (pid->integrator < pid->limMin) {

        pid->integrator = pid->limMin;

    }


	/*
	* Derivative (band-limited differentiator)
	*/

    pid->differentiator = -(2.0f * pid->Kd * (measurement - pid->prevMeasurement)	/* Note: derivative on measurement, therefore minus sign in front of equation! */
                        + (2.0f * pid->tau - pid->T) * pid->differentiator)
                        / (2.0f * pid->tau + pid->T);


	/*
	* Compute output and apply limits
	*/
    pid->out = proportional + pid->integrator + pid->differentiator;

    if (pid->out > pid->limMax) {

        pid->out = pid->limMax;

    } else if (pid->out < pid->limMin) {

        pid->out = pid->limMin;

    }

	/* Store error and measurement for later use */
    pid->prevError       = error;
    pid->prevMeasurement = measurement;

	/* Return controller output */
    return pid->out;

}

void PIDController_Reset(PIDController *pid) {

	/* Clear controller variables */
	pid->integrator = 0.0f;
 	pid->prevError  = 0.0f;

	pid->differentiator  = 0.0f;
	pid->prevMeasurement = 0.0f;

	pid->out = 0.0f;

}
