dpflores/BLDC_Motor_Controller_SEM_2022/(commit log)

2021-11-27 first_PID
    First functional PID for BLDC motor control
2021-12-23 PID funcional con CAN
    [BLDC_Motor_Controller Debug.cfg]
2021-12-23 PID CAN sin SPI
2021-12-26 Sin resto de botones innecesarios
2021-12-26 Zero flag y dos bytes para la velocidad
2021-12-30 Enviando el flag de encendido y apagado
2021-12-30 General flag para el CAN y envio de flag de encendido y apagado
2021-12-30 General flag y power flag
2022-01-15 Medicion de velocidad y PID con frecuencia correcta
    [BLDC_Motor_Controller.ioc, main.c, main.h]
2022-03-17 7 canales de ADC (DMA) con CAN funcional
2022-07-01 Pin Updates for Driver V3
2022-07-01 comunicacion y conmutacion correcto
    [main.c]
